W8jonas/Internet-das-Vacas/relatorios/FUTUROS testes.txt

56 des   // 10 min // 15 // 30 // 45 // 
2 sec trans
2 sec proc
