W8jonas/Internet-das-Vacas/relatorios/Relatório final/Internet das Vacas/sections/Capa_IFMG_modelo_2.tex

\begin{titlepage}
\begin{center}

% logo
~\\[1cm]

{
\newline
}

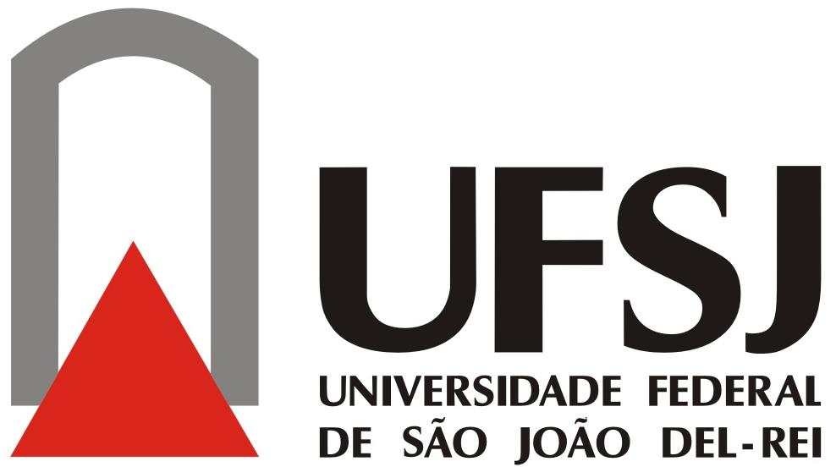
[picture p1: relatorios/Relatório final/Internet das Vacas/img/ufsj_logo.jpg]
~\\[1cm]

\textsc{\Large \\Internet das Vacas: Montagem de Placa de Protótipo de
Dispositivo IoT para Localização Inteligente do Gado}\\[3cm]

{\large \bfseries Autores: Fernando A. Teixeira \\
João Victor Carvalho Tereza \\
Jonas Henrique Nascimento \\}

\vfill

% Bottom of the page
{\large \today}
\end{center}
\end{titlepage}
