W8jonas/Internet-das-Vacas/relatorios/modelos bateria.docx

Essas duas primeiras são aquelas discutidas no último encontro, aparentemente são as melhores opções.

Bateria lipo da FullyMax – Custa 15,20 e é possível comprar nesse endereço:

http://www.asaseletricas.com.br/loja/product_info.php?products_id=4448

Bateria lipo da FullyMax – Custa 14,40 e é possível comprar nesse endereço:

http://www.asaseletricas.com.br/loja/product_info.php?products_id=4301

Em seguida temos o modelo de pilha botão da Rontek, também aparenta ser uma boa escolha, mesmo tendo baixa autonomia. Idealmente, para uma melhor autonomia seria interessante que colocássemos 2 em paralelo para dobrar a autonomia, mas para isso deveríamos adquirir 2 unidades desse modelo.

Bateria botão da Rontek - possível comprar nesses endereços:

https://produto.mercadolivre.com.br/MLB-901873283-bateria-recarregavel-bujo-36v-60mah-2-terminais-c-blister-_JM

https://produto.mercadolivre.com.br/MLB-1014502615-bateria-bujao-36v-80mah-2-terminais-_JM

https://produto.mercadolivre.com.br/MLB-706777674-bateria-bujao-36v-80mah-3-terminais-_JM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

https://produto.mercadolivre.com.br/MLB-706773838-bateria-bujao-36v-80mah-2-terminais-_JM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

Bateria lipo da Rontek –possível comprar nesses endereços:

https://produto.mercadolivre.com.br/MLB-1005574636-bateria-37v-400mah-litio-polimero-35038-_JM

https://produto.mercadolivre.com.br/MLB-1039593189-bateria-37v-450mah-litio-polimero-conector-jstp-phr-3-vias-_JM

https://produto.mercadolivre.com.br/MLB-875933973-bateria-prismatica-37v-800mah-icr063048-li-on-_JM

Bateria 18650 – Possível comprar nesses endereços:

https://pt.aliexpress.com/item/2018-1pcs-ICR-Best-selling-High-capacity-18650-rechargeable-battery-3-7V-Li-ion-Battery-for/32861972053.html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,searchweb201602_3_10152_10151_10065_10344_10068_10547_10342_10343_10340_10548_10341_10696_10084_10083_10618_10307_10846_10059_100031_524_10103_10624_10623_10622_10621_10620,searchweb201603_35,ppcSwitch_5&algo_expid=9de6b547-f8e6-4d9c-b980-1e628551992f-0&algo_pvid=9de6b547-f8e6-4d9c-b980-1e628551992f&priceBeautifyAB=0

modelo para shield:

https://produto.mercadolivre.com.br/MLB-753880552-bateria-para-radio-motorola-bp38-48v-700mah-aaa-_JM

https://produto.mercadolivre.com.br/MLB-904600437-pack-bateria-48v-700mah-bp38-radios-talkabout-intelbras-_JM
