W8jonas/Internet-das-Vacas/relatorios/Relatório final/Internet das Vacas/sections/Apendice_A.tex

\newpage
\section{Apêndice A - Tabela de valores de consumo completa}
\label{sc:apendice_a_}

{
Os valores mostrados nessa tabela foram aferidos utilizando 3 multímetros de marcas e modelos diferentes, com a principal finalidade de se chegar a uma média precisa do valor de consumo em cada situação descrita na tabela.
}

\includepdf[pages=-]{Adicionais/Tabela_valores_de_consumo_ESP.pdf}
