W8jonas/Internet-das-Vacas/relatorios/gráficos 1.xlsx

Sheet: Planilha1
valor x | valor y | valor w | em horas | em dias | valor w | em horas
3600 | 0 | 0 | 751.8796992 | 31.3283208 | 0 | 751.8796992
3599 | 0 | 1 | 649.9368117 | 27.08070049 | 1 | 649.9368117
3598 | 0 | 2 | 572.3370429 | 23.84737679 | 2 | 572.3370429
3597 | 0 | 3 | 511.2910098 | 21.30379207 | 3 | 511.2910098
3596 | 0 | 4 | 462.0123203 | 19.25051335 | 4 | 462.0123203
3595 | 0 | 5 | 421.3976355 | 17.55823481 | 5 | 421.3976355
3594 | 0 | 6 | 387.3466753 | 16.1394448 | 6 | 387.3466753
3593 | 0 | 7 | 358.3872573 | 14.93280239 | 7 | 358.3872573
3592 | 0 | 8 | 333.4568359 | 13.89403483 | 8 | 333.4568359
3591 | 0 | 9 | 311.7692907 | 12.99038711 | 9 | 311.7692907
3590 | 0 | 10 | 292.7305253 | 12.19710522 | 10 | 292.7305253
3589 | 0 | 11 | 275.8832094 | 11.49513373 | 11 | 275.8832094
3588 | 0 | 12 | 260.8695652 | 10.86956522 | 12 | 260.8695652
3587 | 0 | 13 | 247.4056766 | 10.30856986 | 13 | 247.4056766
3586 | 0 | 14 | 235.2633643 | 9.802640178 | 14 | 235.2633643
3585 | 0 | 15 | 224.2571482 | 9.344047842 | 15 | 224.2571482
3584 | 0 | 16 | 214.234706 | 8.926446084 | 16 | 214.234706
3583 | 0 | 17 | 205.0697807 | 8.544574195 | 17 | 205.0697807
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
