W8jonas/Internet-das-Vacas/relatorios/tabela 3.xlsx

Função em teste |  | VCC (V) | Mínimo (mA) | Máximo (mA) | Média (mA)
Standby(1) |  | 5 | 74,4(2) | 76.1 | 75.33333
 |  |  | 74,5(3) | 75.6
 |  |  | 75,2(4) | 76.2
 |  | 4 | 74.8 | 76 | 75.58333
 |  |  | 74.3 | 77.6
 |  |  | 74.8 | 76
 |  | 3.4 | 73.3 | 74.8 | 74.05000
 |  |  | 73.2 | 74.2
 |  |  | 73.6 | 75.2
1 Led ligado(5) |  | 5 | 75.5 | 75.2 | 75.58333
 |  |  | 75.3 | 75.3
 |  |  | 75.8 | 76.4
 |  | 4 | 75.4 | 76.8 | 76.15000
 |  |  | 75.2 | 76.5
 |  |  | 75.8 | 77.2
 |  | 3.4 | 73.8 | 74.8 | 74.36667
 |  |  | 73.3 | 74.6
 |  |  | 73.9 | 75.8
Todos os Leds ligados |  | 5 | 78.6 | 80 | 79.30000
 |  |  | 78.3 | 80.1
 |  |  | 78.8 | 80
 |  | 4 | 78.6 | 79.5 | 79.06667
 |  |  | 78.2 | 79.3
 |  |  | 78.8 | 80
 |  | 3.4 | 76.2 | 78.1 | 77.13333
 |  |  | 75.9 | 77.2
 |  |  | 76.5 | 78.9
100% uso do CPU(6) |  | 5 | 76 | 77.3 | 76.90000
 |  |  | 76 | 76.3
 |  |  | 76.6 | 79.2
 |  | 4 | 75.5 | 76.6 | 76.23333
 |  |  | 75.3 | 76.6
 |  |  | 75.9 | 77.5
 |  | 3.4 | 74.8 | 75.5 | 75.16667
 |  |  | 74.4 | 75.2
 |  |  | 74.9 | 76.2
1 Led ligado + 100% uso CPU |  | 5 | 76.8 | 78.1 | 77.78333
 |  |  | 76.4 | 77.7
 |  |  | 78.2 | 79.5
 |  | 4 | 76.8 | 77.6 | 77.38333
 |  |  | 76.7 | 77.3
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
