W8jonas/Internet-das-Vacas/relatorios/filtro para tabela modelos de bateria minamoto.xlsx

Tabela retirada DIRETAMENTE do site minamoto. Pode ser acessado inteiramente no link: http://www.minamoto.com/12591-2/
Data de acesso: 05/06/2018
Model | Nominal Capacity (mAh) | Nominal Voltage (V) | Thickness (mm) | Width (mm) | Height (mm) | Weight (g) | Max. Continuous Current | Max. Pulse Current
Model | Nominal Capacity (mAh) | Nominal Voltage (V) | Thickness (mm) | Width (mm) | Height (mm) | Weight (g) | Max. Continuous Current | Max. Pulse Current
LP8574135 | 10Ah | 3.7 | 8.7 | 73.5 | 135 | 136 | 1C | 2C
LP7543128 | 5000 | 3.7 | 7.7 | 43 | 128 | 94 | 1C | 2C
LP8045135P | 5000 | 3.7 | 8 | 45 | 135 | 106 | 1C | 2C
LP6848135 | 5000 | 3.7 | 6.5 | 48 | 135 | 88 | 1C | 2C
LP104884 | 5000 | 3.7 | 10 | 48 | 84 | 86 | 1C | 2C
LP806580 | 5000 | 3.7 | 8.5 | 65 | 80 | 92 | 1C | 2C
LP805095 | 4500 | 3.7 | 7.8 | 50 | 95 | 81 | 1C | 2C
LP5548135 | 4200 | 3.7 | 5.6 | 48 | 135 | 79 | 1C | 2C
LP5567102 | 4100 | 3.7 | 4.8 | 66 | 102 | 73 | 1C | 2C
LP6443128 | 4000 | 3.7 | 6 | 43 | 128 | 73 | 1C | 2C
LP824884 | 4000 | 3.7 | 8.5 | 48 | 84 | 73 | 1C | 2C
LP705585 | 4000 | 3.7 | 7.2 | 55 | 85 | 72 | 1C | 2C
LP804884 | 3900 | 3.7 | 7.8 | 48 | 84 | 68 | 1C | 2C
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
