W8jonas/Internet-das-Vacas/relatorios/Internet das vacas PIBIC-Jonas.xlsx

Data | Dia da semana | Atividade realizada
2018-02-27 | Terça-feira | Confirmação da Fapemig
2018-02-28 | Quarta-feira | Coleta das assinaturas
2018-03-03 | Sábado | Cadastramento EVEREST
2018-03-21 | Quarta-feira | Confirmação da proposta no EVEREST
