W8jonas/Internet-das-Vacas/imagens/Circuito leitor de tensao/01.jpeg

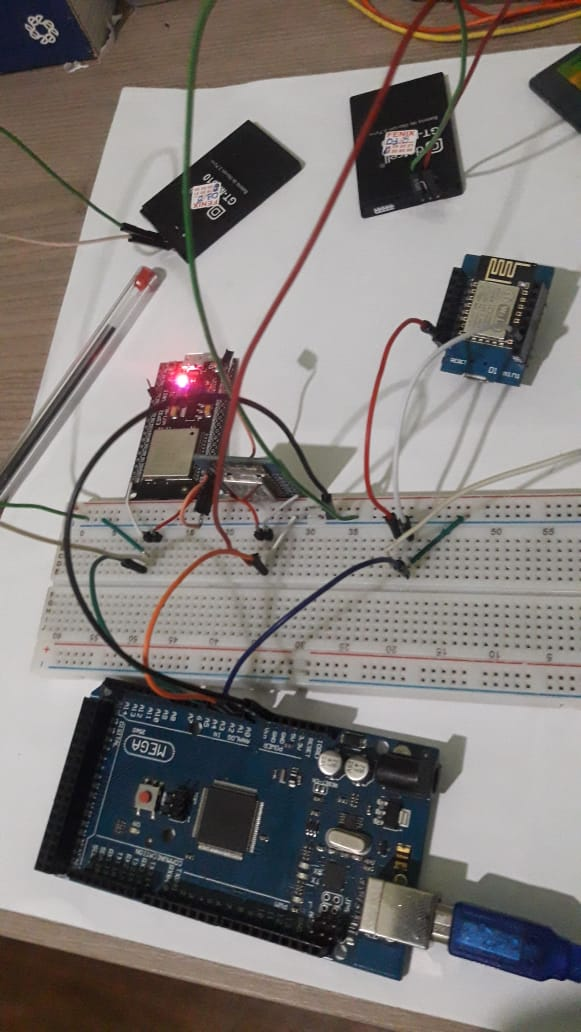
imagens/Circuito leitor de tensao/01.jpeg
