W8jonas/Internet-das-Vacas/imagens/Circuito leitor de tensao/02.jpeg

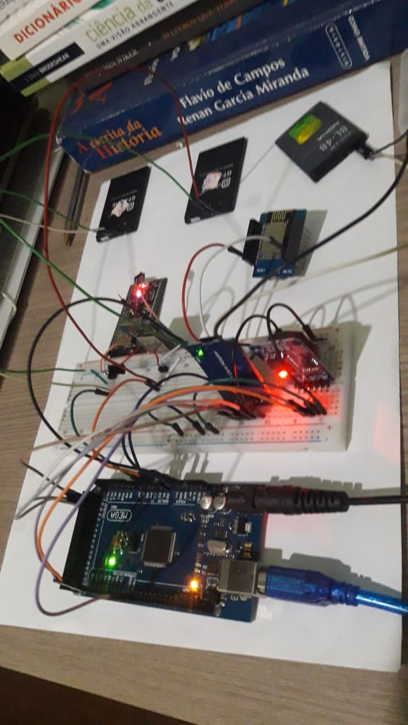
imagens/Circuito leitor de tensao/02.jpeg
