W8jonas/Internet-das-Vacas/imagens/Circuito leitor de tensao/03.jpeg

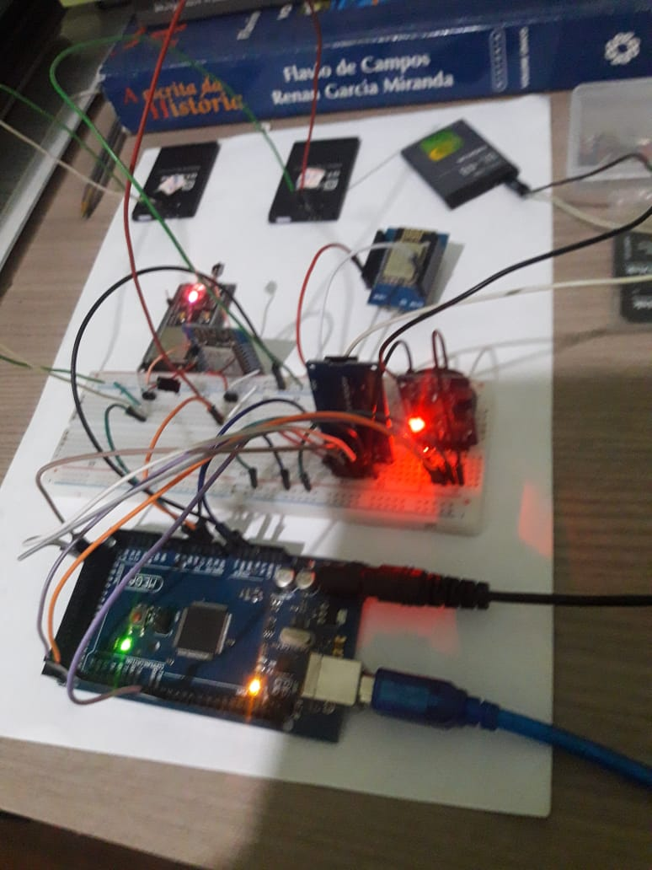
imagens/Circuito leitor de tensao/03.jpeg
