W8jonas/Internet-das-Vacas/imagens/Circuito leitor de tensao/06.jpeg

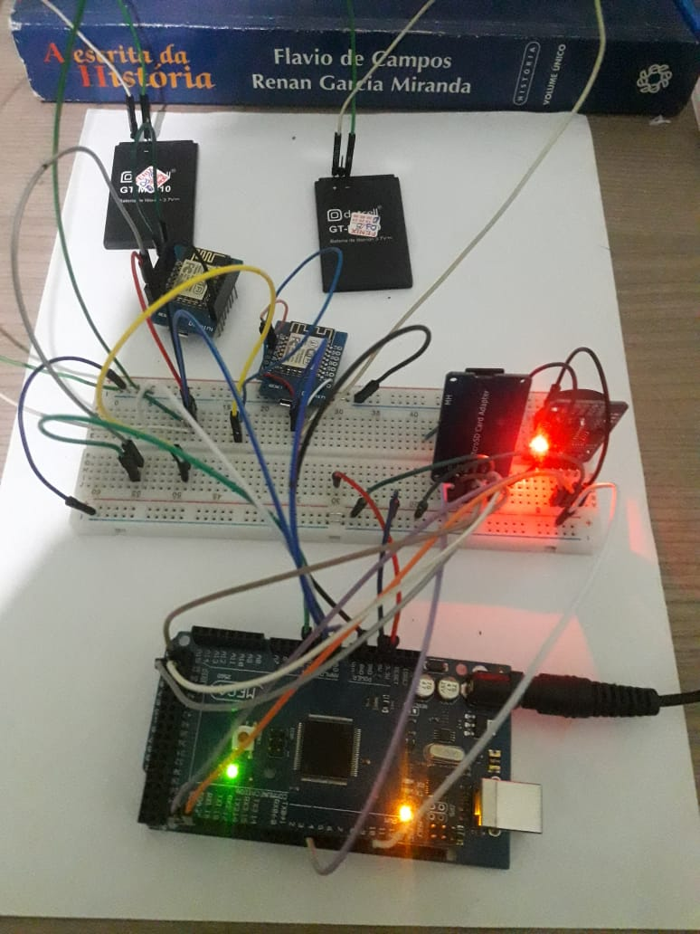
imagens/Circuito leitor de tensao/06.jpeg
