W8jonas/Internet-das-Vacas/imagens/Circuito leitor de tensao/07.jpeg

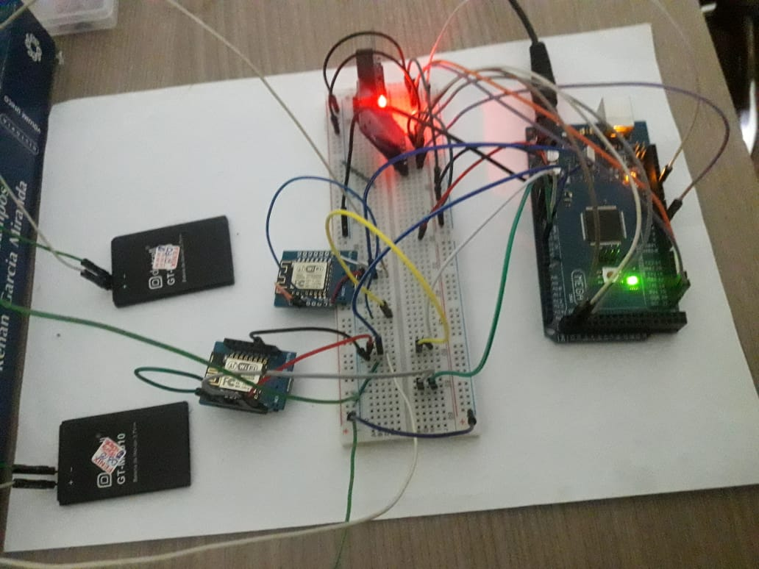
imagens/Circuito leitor de tensao/07.jpeg
