W8jonas/Internet-das-Vacas/imagens/Circuito leitor de tensao/08.jpeg

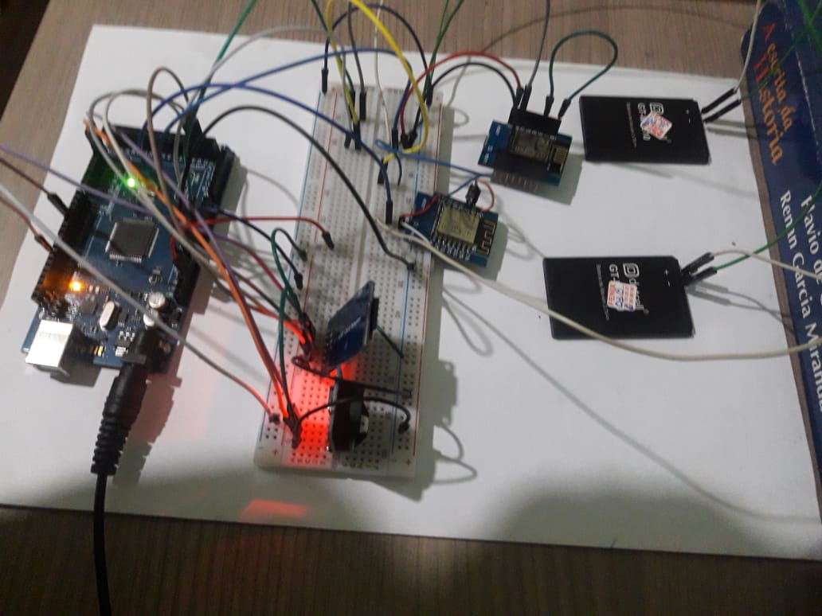
imagens/Circuito leitor de tensao/08.jpeg
