W8jonas/Internet-das-Vacas/imagens/Circuito leitor de tensao/09.jpeg

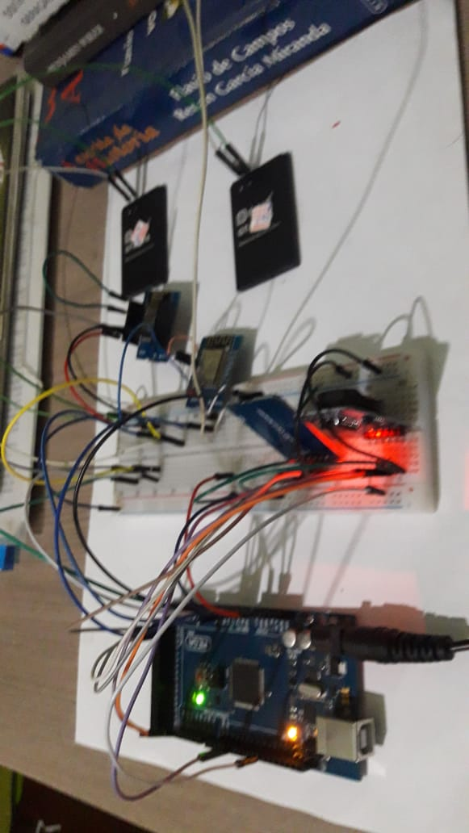
imagens/Circuito leitor de tensao/09.jpeg
