W8jonas/Internet-das-Vacas/imagens/Circuito leitor de tensao/10.jpeg

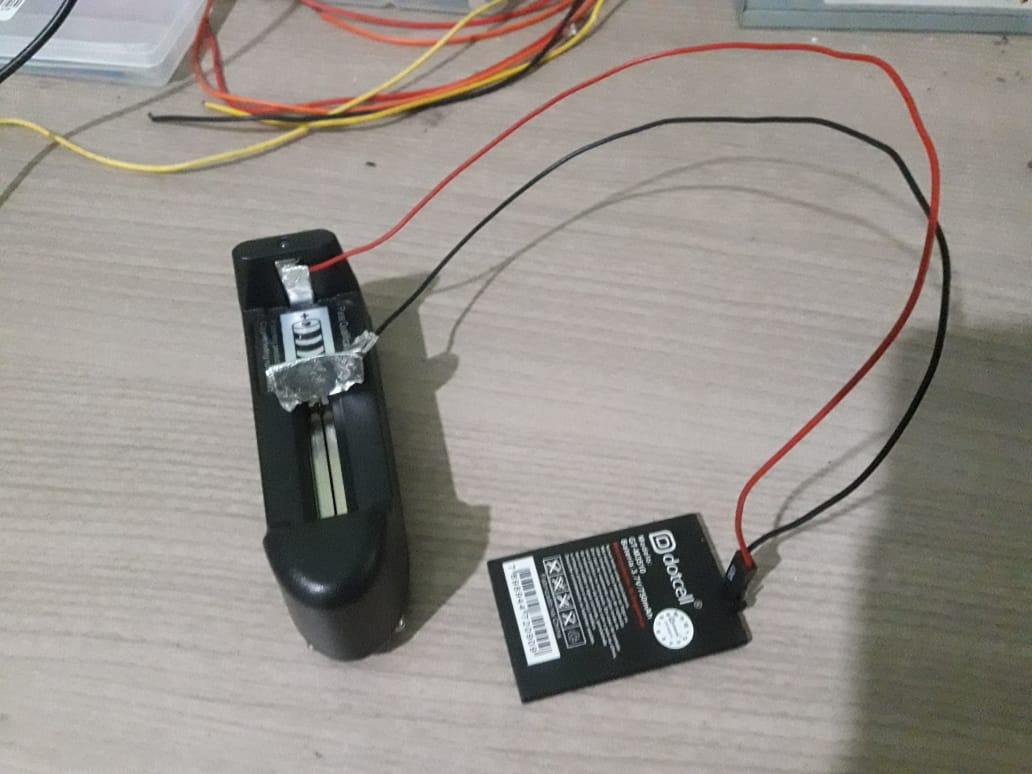
imagens/Circuito leitor de tensao/10.jpeg
