W8jonas/Internet-das-Vacas/imagens/Protótipo 1 ESP32/01.jpeg

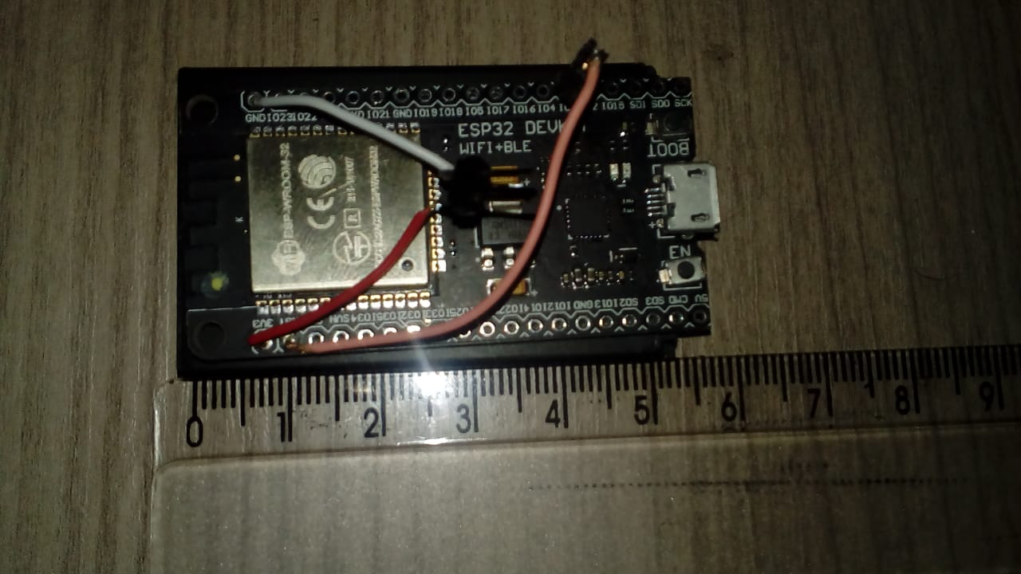
imagens/Protótipo 1 ESP32/01.jpeg
