W8jonas/Internet-das-Vacas/imagens/Protótipo 1 ESP32/03.jpeg

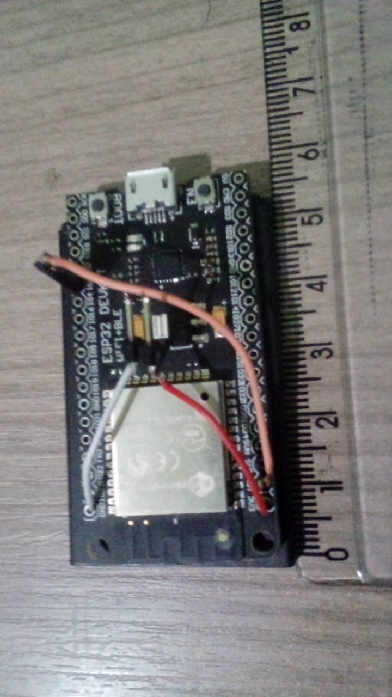
imagens/Protótipo 1 ESP32/03.jpeg
