W8jonas/Internet-das-Vacas/imagens/Protótipo 1 ESP32/10.jpeg

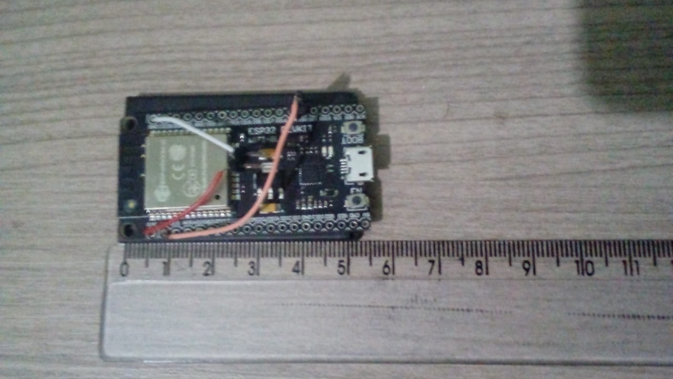
imagens/Protótipo 1 ESP32/10.jpeg
