W8jonas/Internet-das-Vacas/imagens/Protótipo 1 ESP8266/02.jpeg

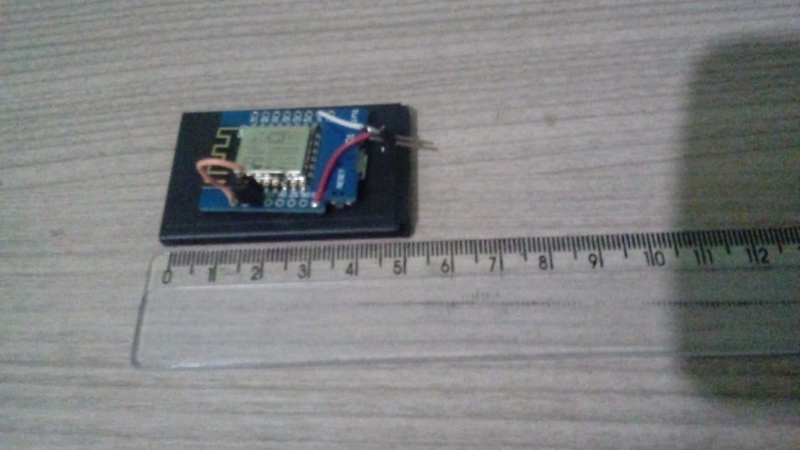
imagens/Protótipo 1 ESP8266/02.jpeg
