W8jonas/Internet-das-Vacas/imagens/Protótipo 1 ESP8266/07.jpeg

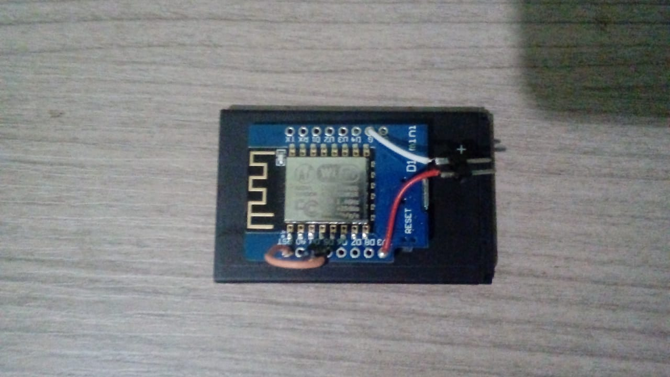
imagens/Protótipo 1 ESP8266/07.jpeg
