W8jonas/Internet-das-Vacas/imagens/Protótipo 1 ESP8266/11.jpeg

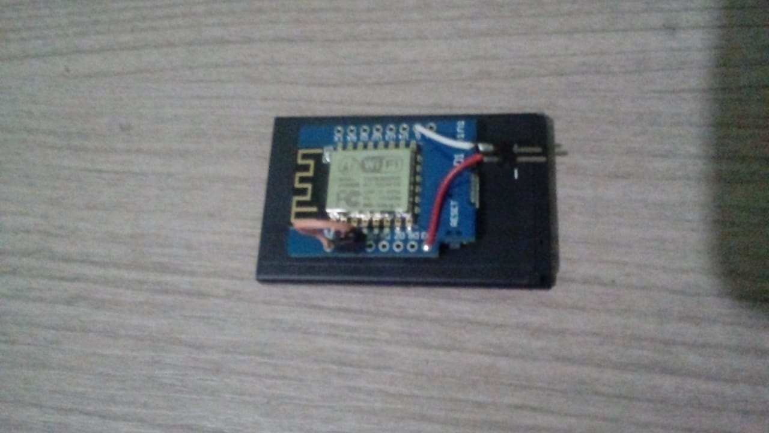
imagens/Protótipo 1 ESP8266/11.jpeg
