W8jonas/Internet-das-Vacas/imagens/Protótipo 1/01.jpeg

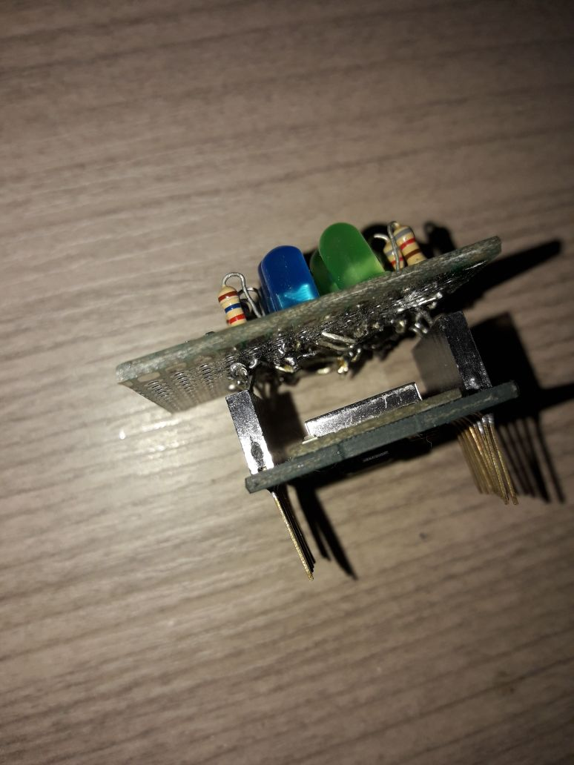
imagens/Protótipo 1/01.jpeg
