W8jonas/Internet-das-Vacas/imagens/Protótipo 1/02.jpeg

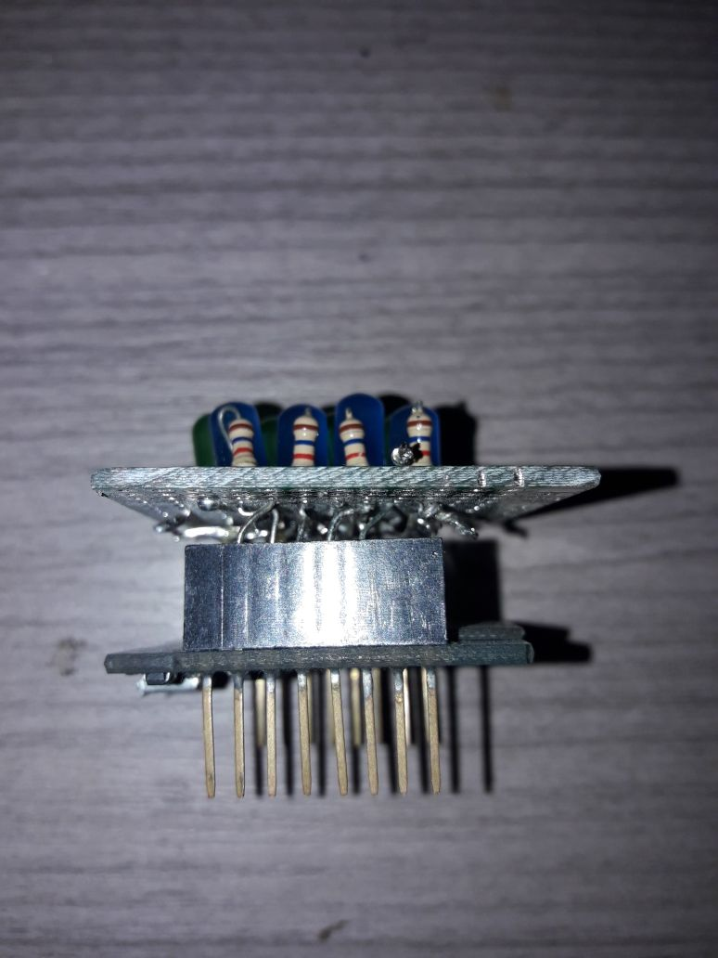
imagens/Protótipo 1/02.jpeg
