W8jonas/Internet-das-Vacas/imagens/Protótipo 1/04.jpeg

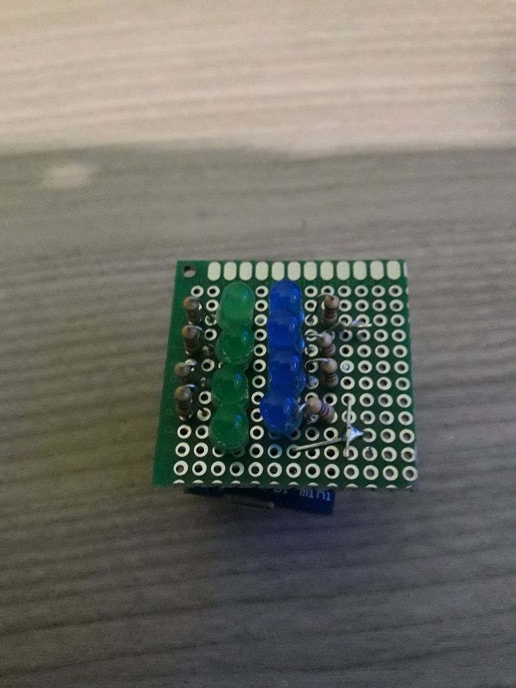
imagens/Protótipo 1/04.jpeg
