W8jonas/Internet-das-Vacas/imagens/Protótipo 1/05.jpeg

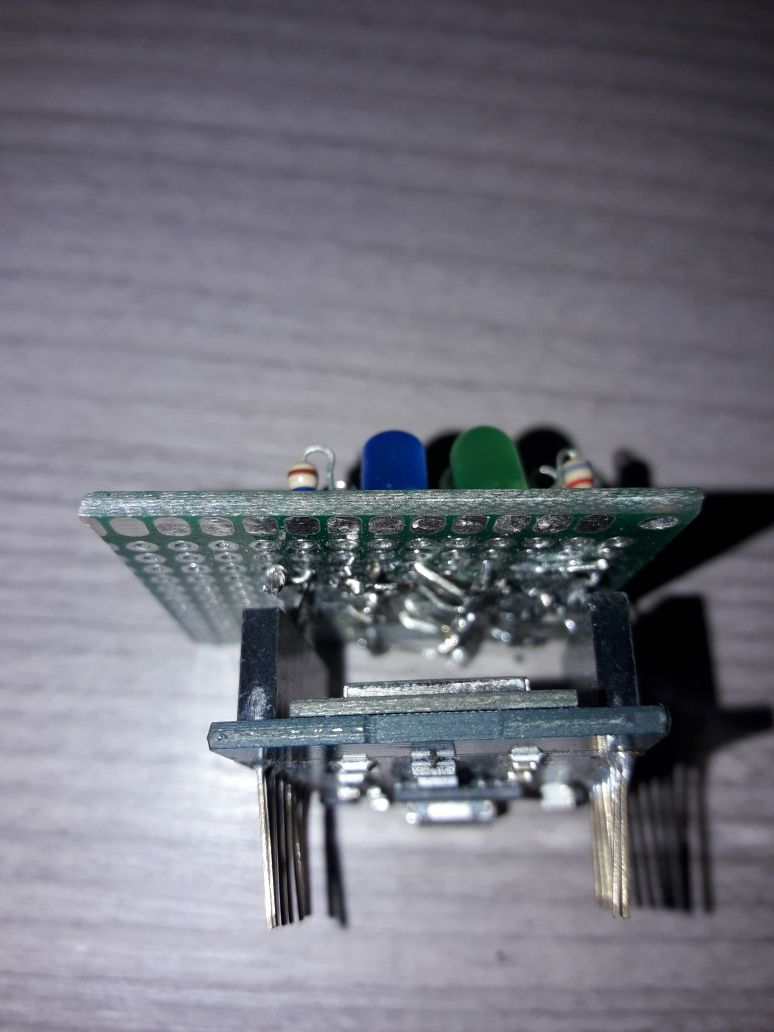
imagens/Protótipo 1/05.jpeg
