W8jonas/Internet-das-Vacas/imagens/Protótipo 1/06.jpeg

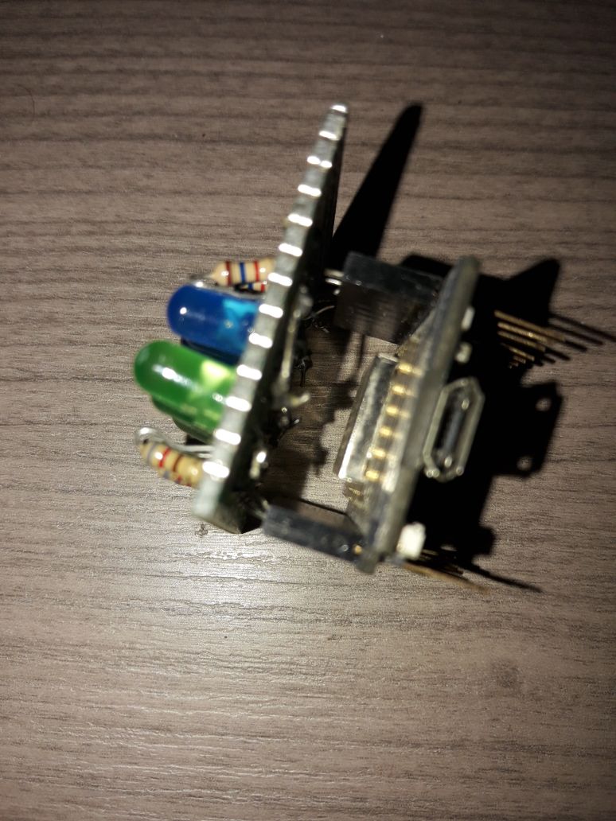
imagens/Protótipo 1/06.jpeg
