W8jonas/Internet-das-Vacas/imagens/Protótipo 1/07.jpeg

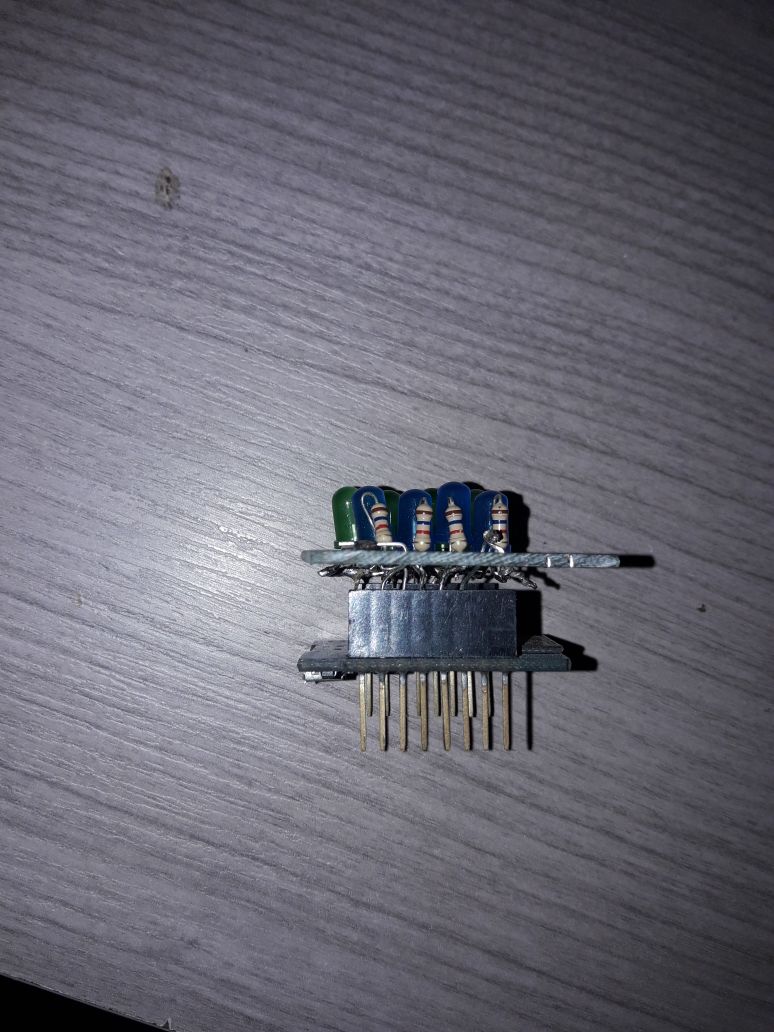
imagens/Protótipo 1/07.jpeg
