W8jonas/Internet-das-Vacas/imagens/Protótipo 1/08.jpeg

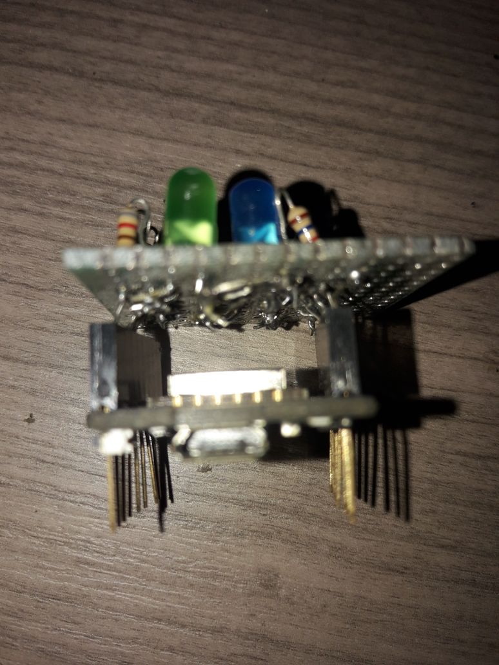
imagens/Protótipo 1/08.jpeg
