W8jonas/Internet-das-Vacas/imagens/Protótipo 1/10.jpeg

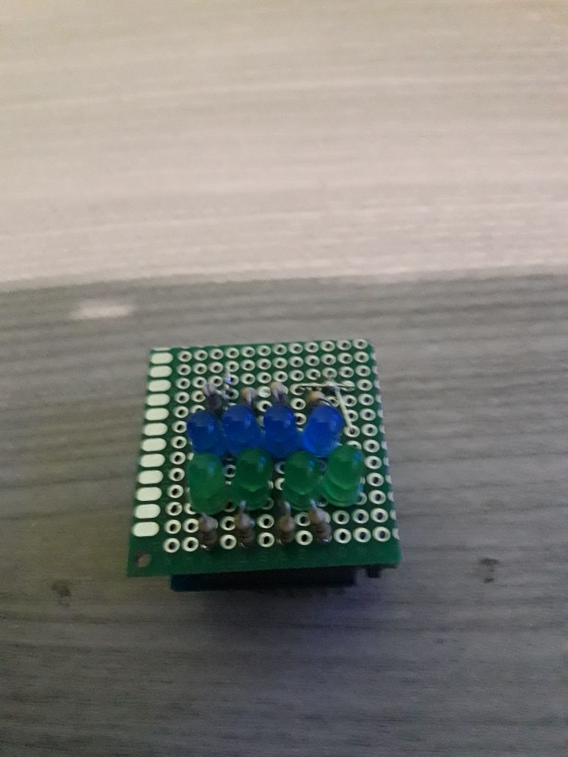
imagens/Protótipo 1/10.jpeg
