W8jonas/Internet-das-Vacas/imagens/Protótipo 1/11.jpeg

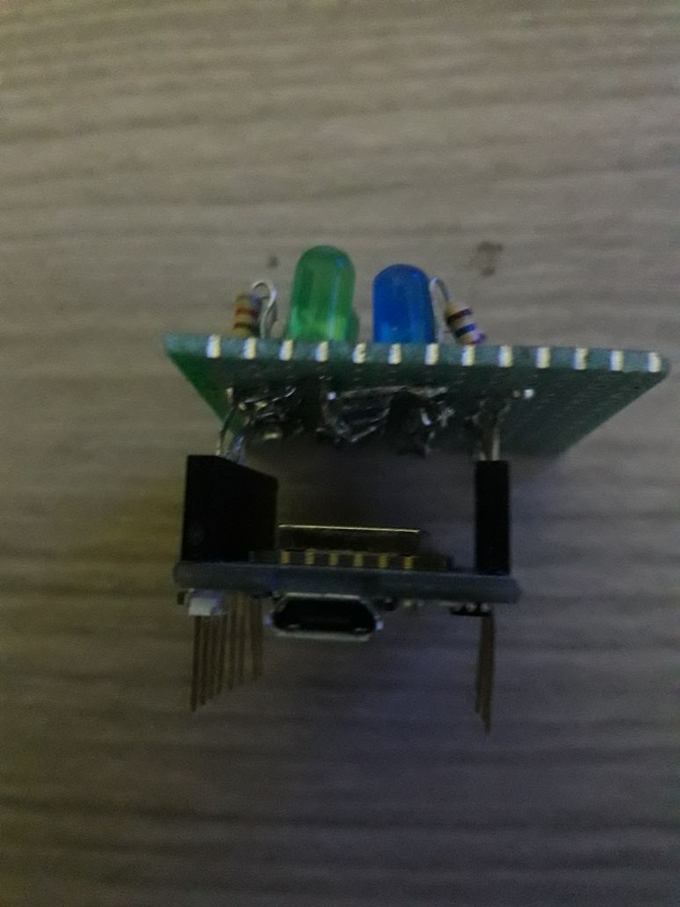
imagens/Protótipo 1/11.jpeg
