W8jonas/Internet-das-Vacas/imagens/Protótipo 1/13.jpeg

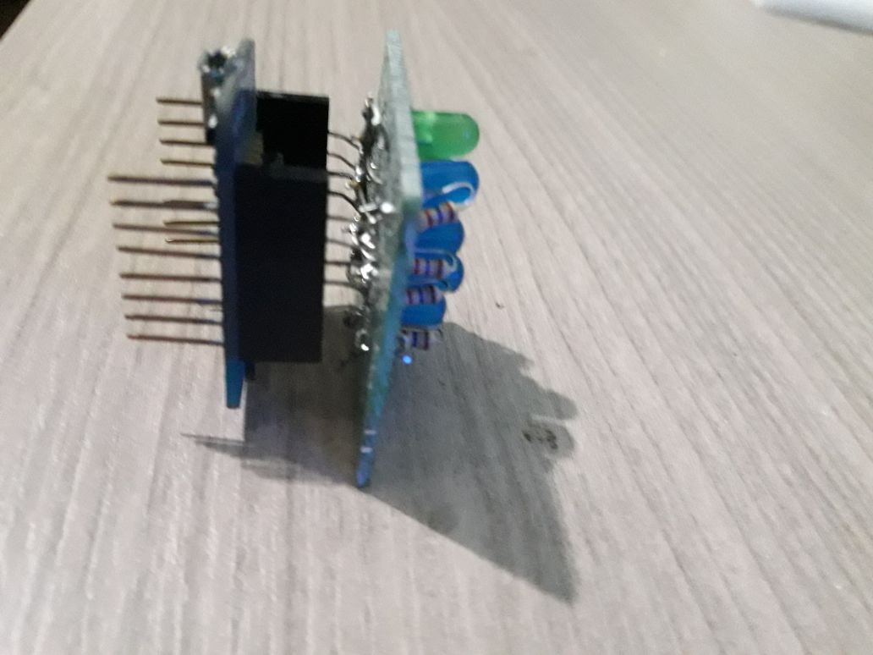
imagens/Protótipo 1/13.jpeg
