W8jonas/Internet-das-Vacas/imagens/Protótipo 1/14.jpeg

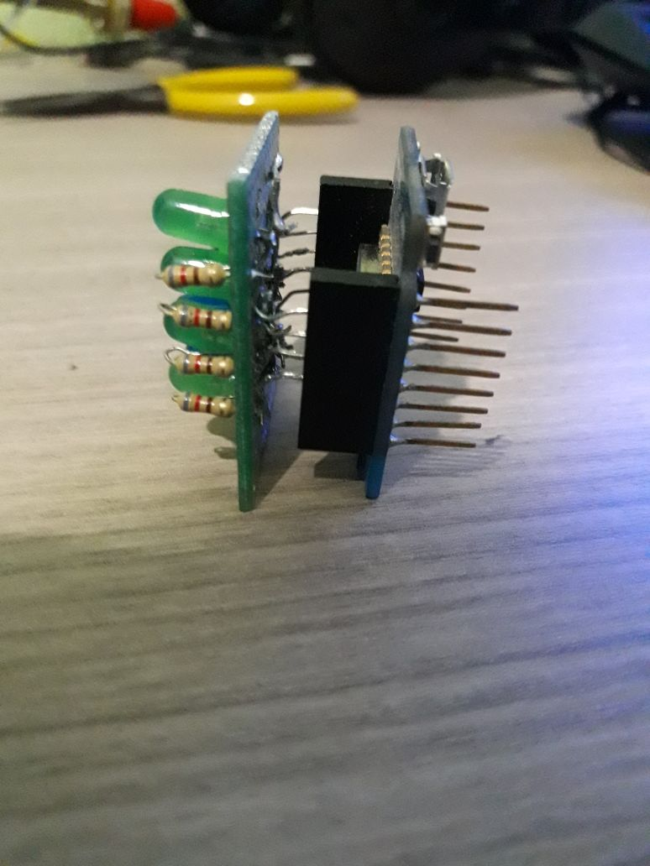
imagens/Protótipo 1/14.jpeg
