W8jonas/Internet-das-Vacas/imagens/Protótipo 1/15.jpeg

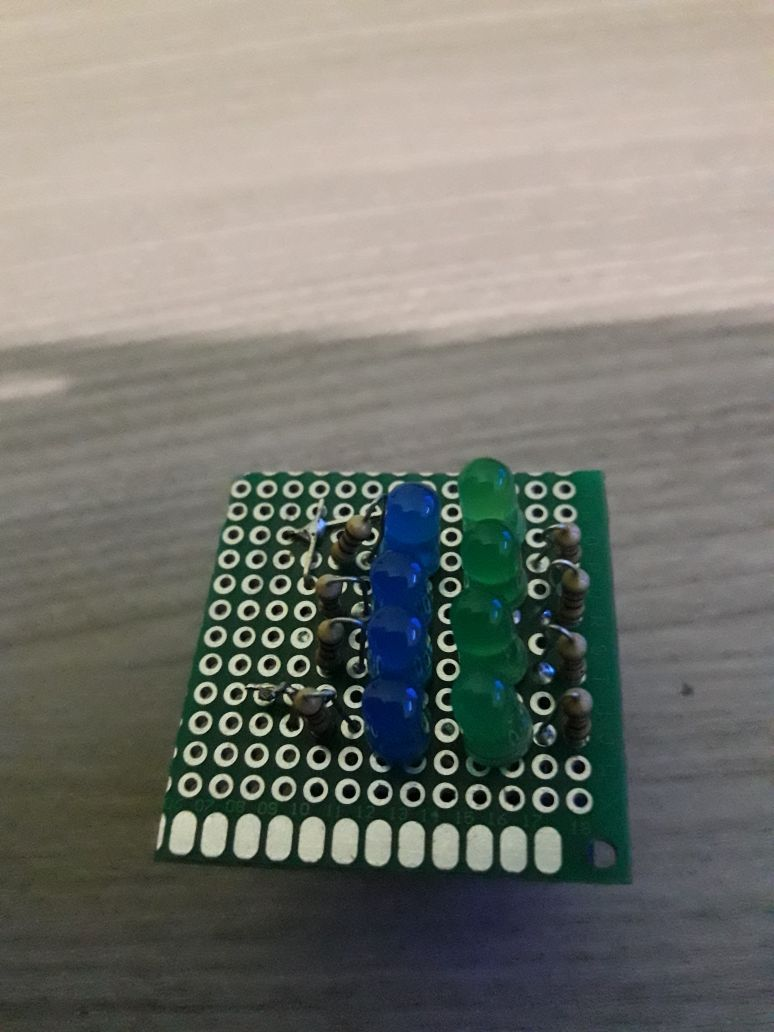
imagens/Protótipo 1/15.jpeg
