W8jonas/Internet-das-Vacas/imagens/Protótipo 1/16.jpeg

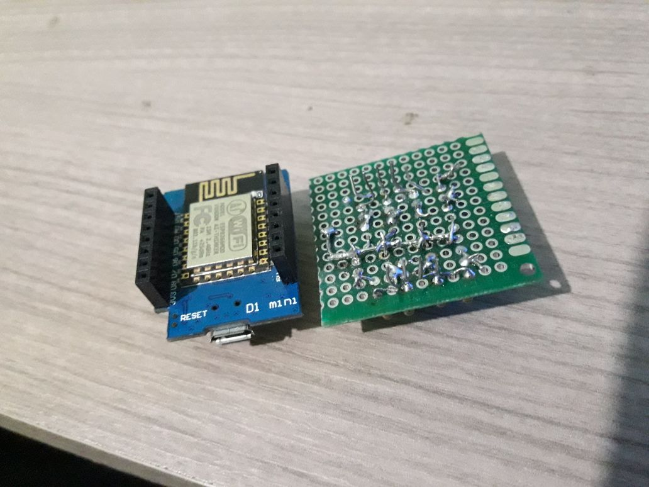
imagens/Protótipo 1/16.jpeg
