W8jonas/Internet-das-Vacas/imagens/Protótipo 2/02.jpeg

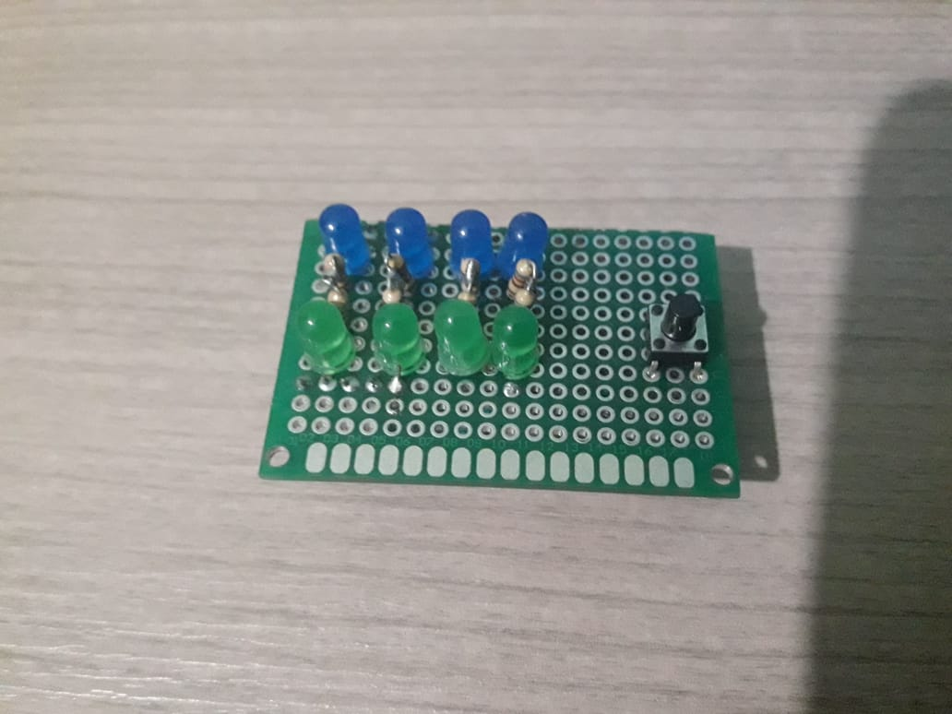
imagens/Protótipo 2/02.jpeg
