W8jonas/Internet-das-Vacas/imagens/Protótipo 2/04.jpeg

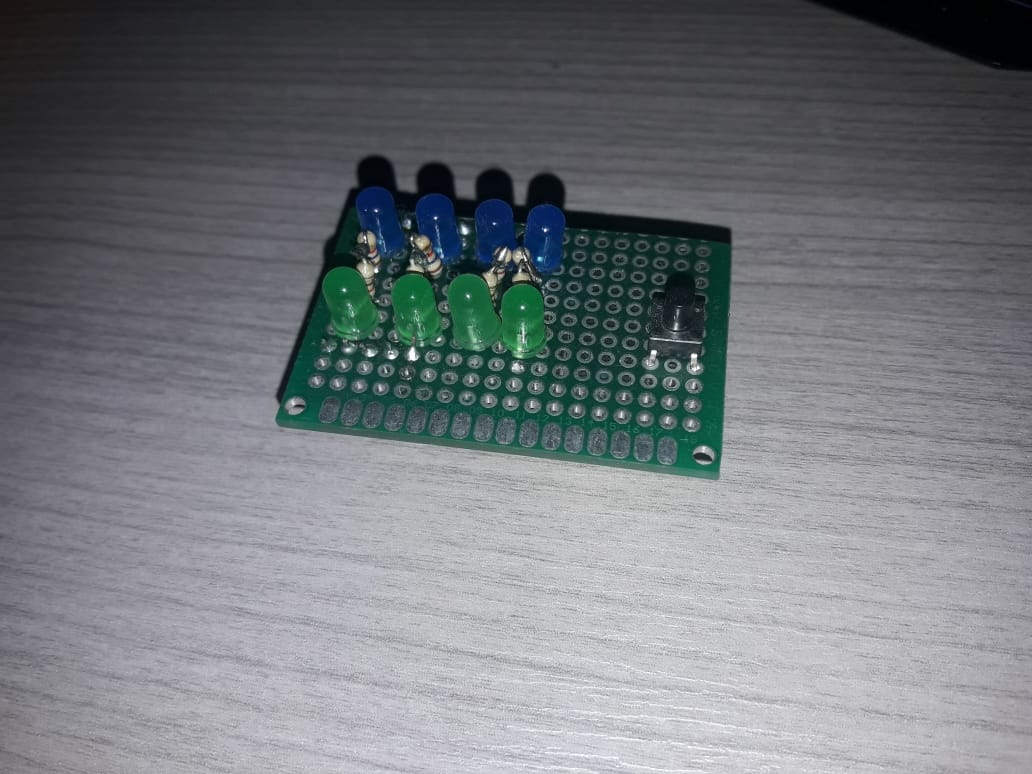
imagens/Protótipo 2/04.jpeg
