W8jonas/Internet-das-Vacas/imagens/Protótipo 2/05.jpeg

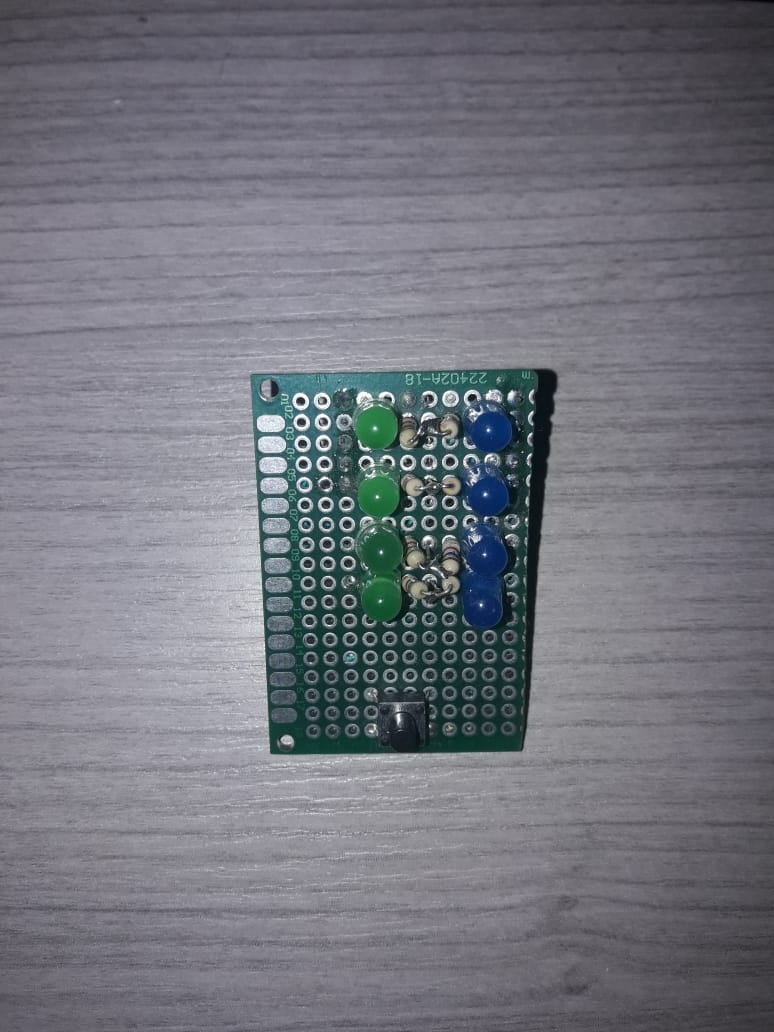
imagens/Protótipo 2/05.jpeg
