W8jonas/Internet-das-Vacas/imagens/Protótipo 2/06.jpeg

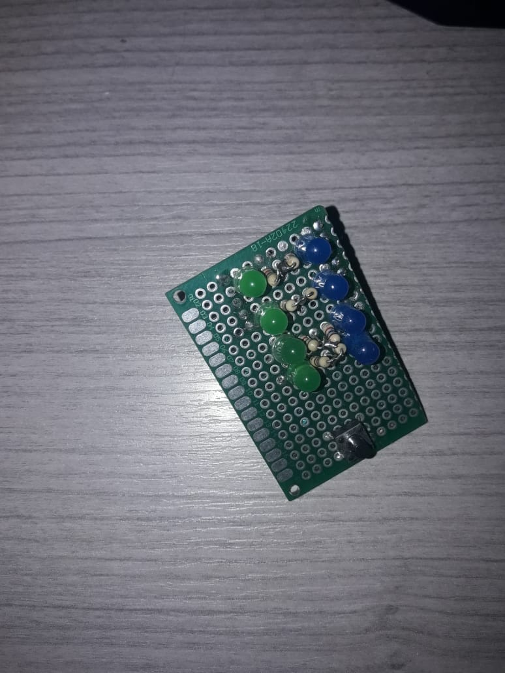
imagens/Protótipo 2/06.jpeg
