W8jonas/Internet-das-Vacas/imagens/Protótipo 2/07.jpeg

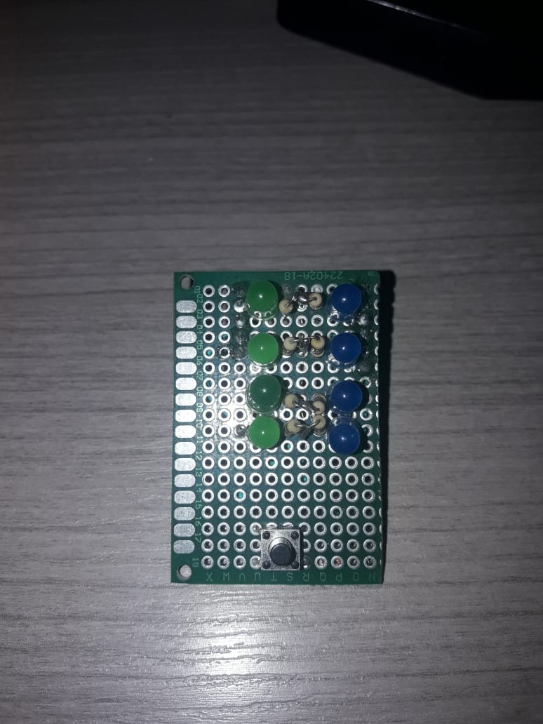
imagens/Protótipo 2/07.jpeg
