W8jonas/Internet-das-Vacas/imagens/Protótipo 2/08.jpeg

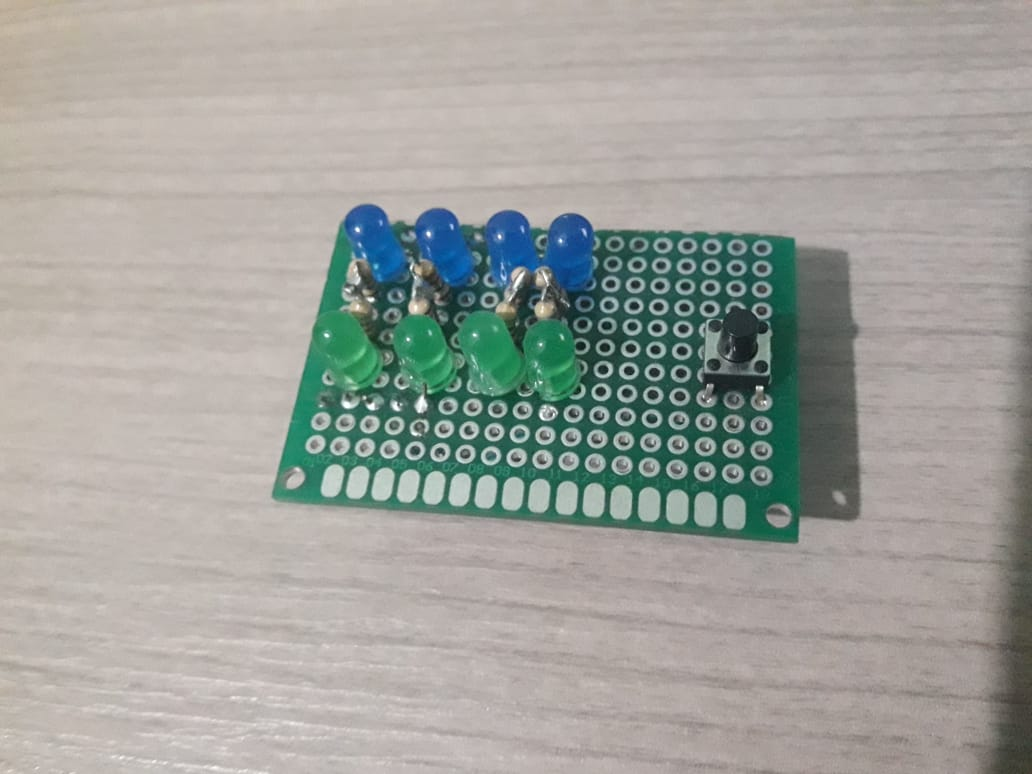
imagens/Protótipo 2/08.jpeg
