W8jonas/Internet-das-Vacas/imagens/Protótipo 2/09.jpeg

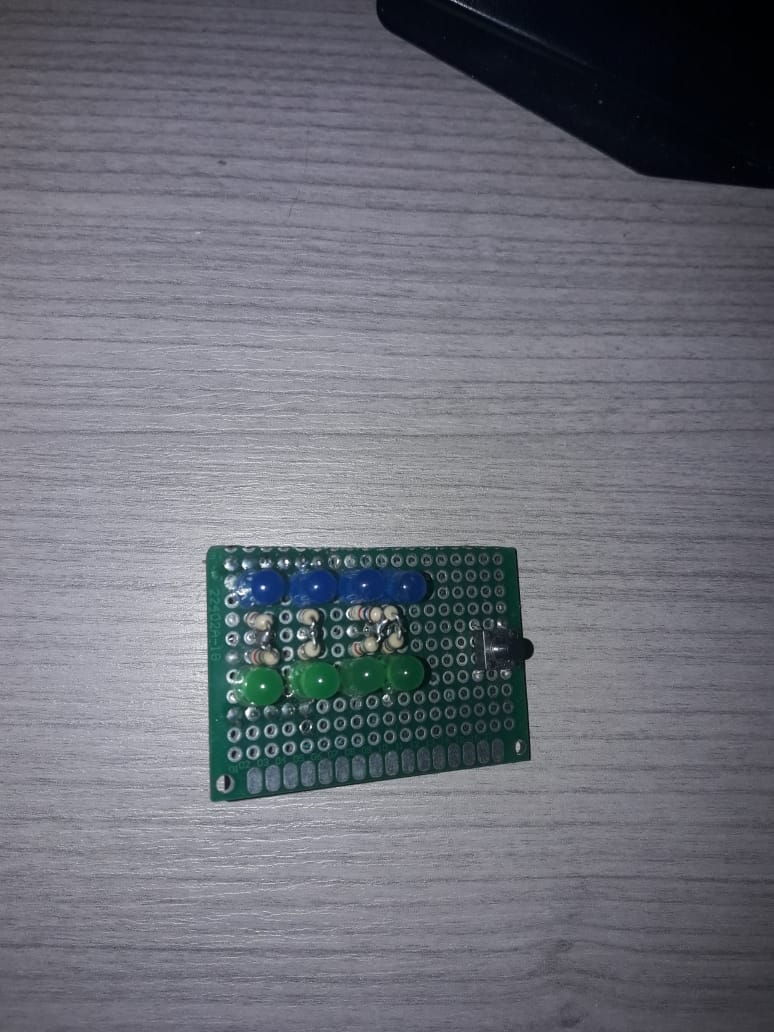
imagens/Protótipo 2/09.jpeg
