W8jonas/Internet-das-Vacas/imagens/Protótipo 2/10.jpeg

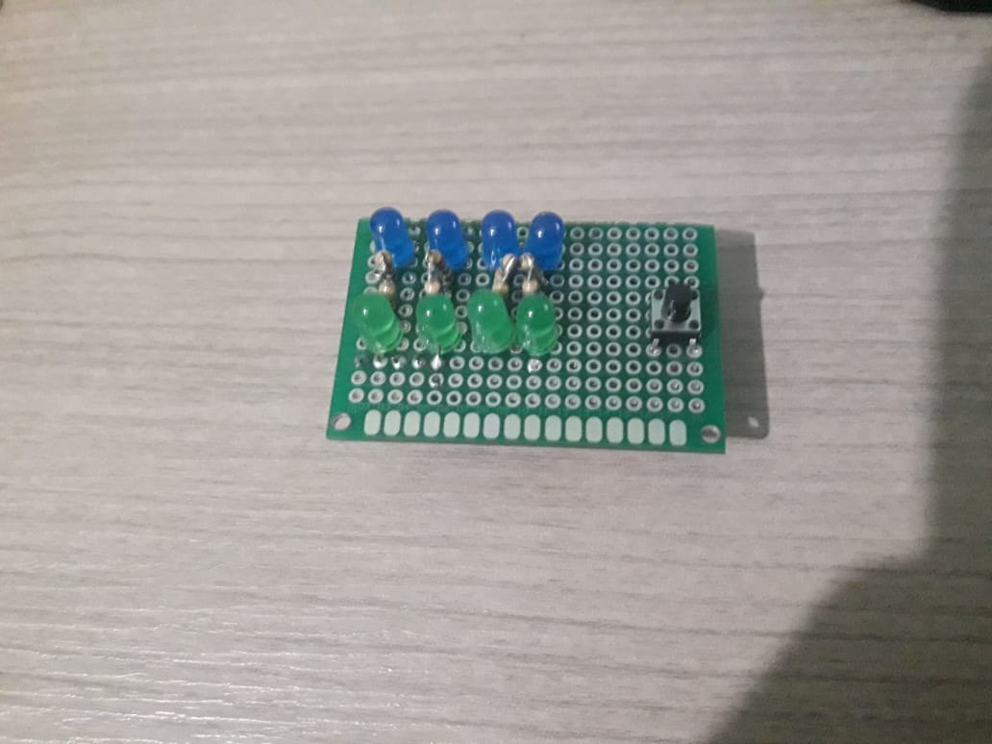
imagens/Protótipo 2/10.jpeg
