W8jonas/Internet-das-Vacas/imagens/Protótipo 2/11.jpeg

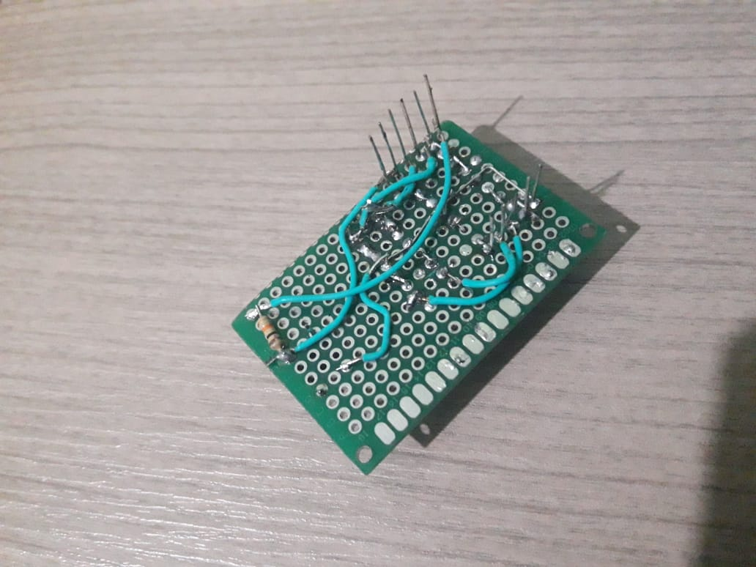
imagens/Protótipo 2/11.jpeg
