W8jonas/Internet-das-Vacas/imagens/Protótipo 2/12.jpeg

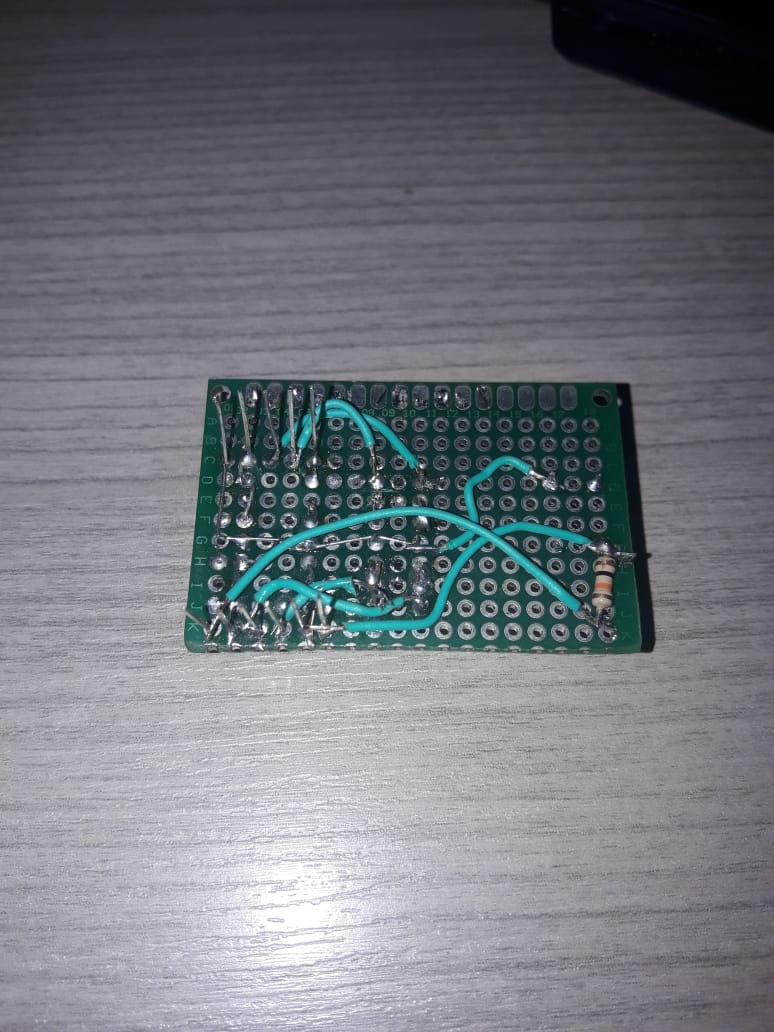
imagens/Protótipo 2/12.jpeg
