W8jonas/Internet-das-Vacas/imagens/Protótipo 2/13.jpeg

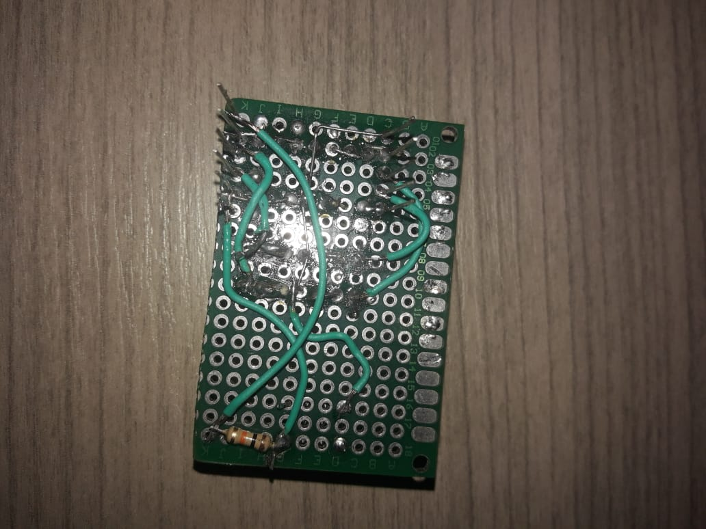
imagens/Protótipo 2/13.jpeg
