W8jonas/Internet-das-Vacas/imagens/Protótipo 2/14.jpeg

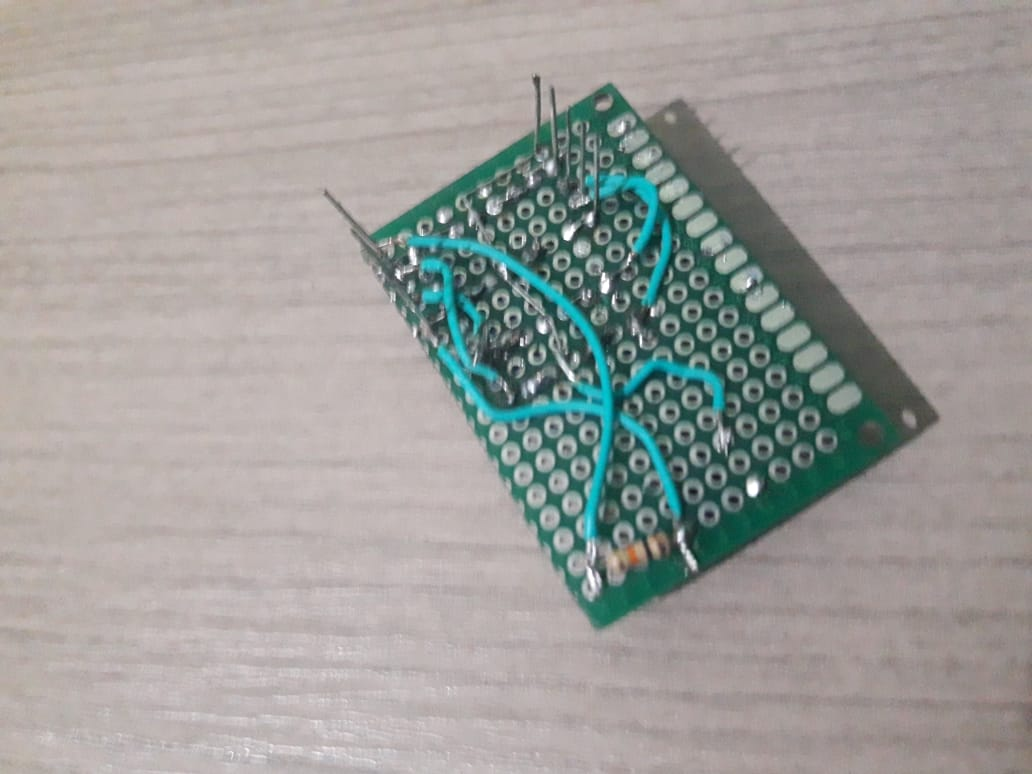
imagens/Protótipo 2/14.jpeg
