W8jonas/Internet-das-Vacas/imagens/protótipo ESP8266.jpeg

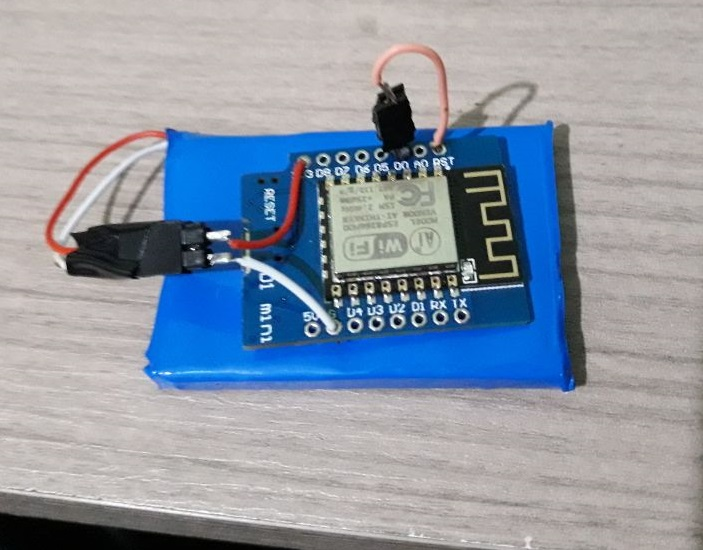
imagens/protótipo ESP8266.jpeg
