W8jonas/Internet-das-Vacas/imagens/RSSI e NOT-RSSI.png

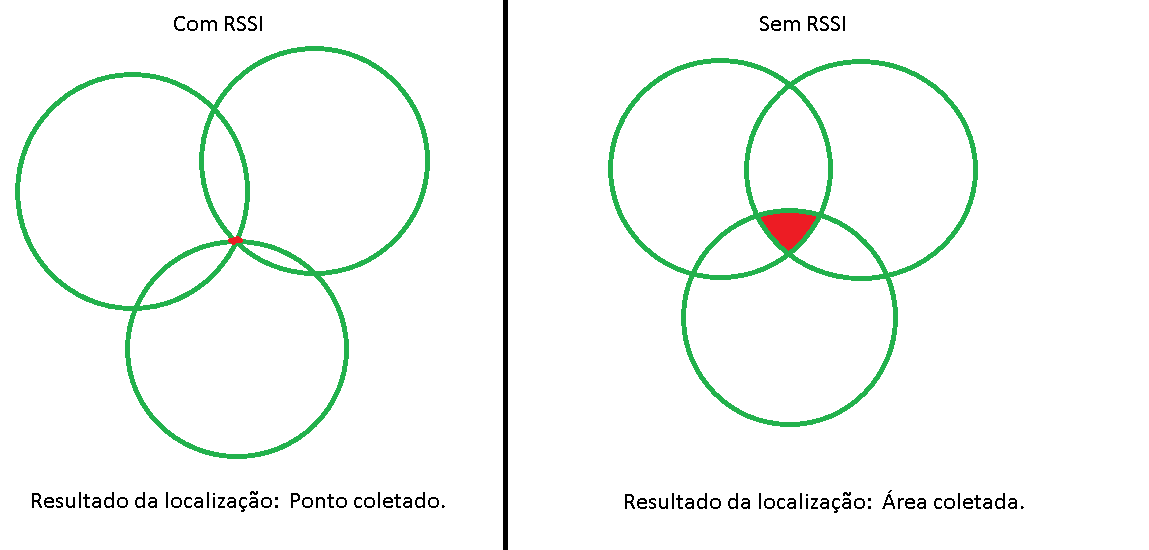
imagens/RSSI e NOT-RSSI.png
