W8jonas/Internet-das-Vacas/relatorios/compras masterwalker.png

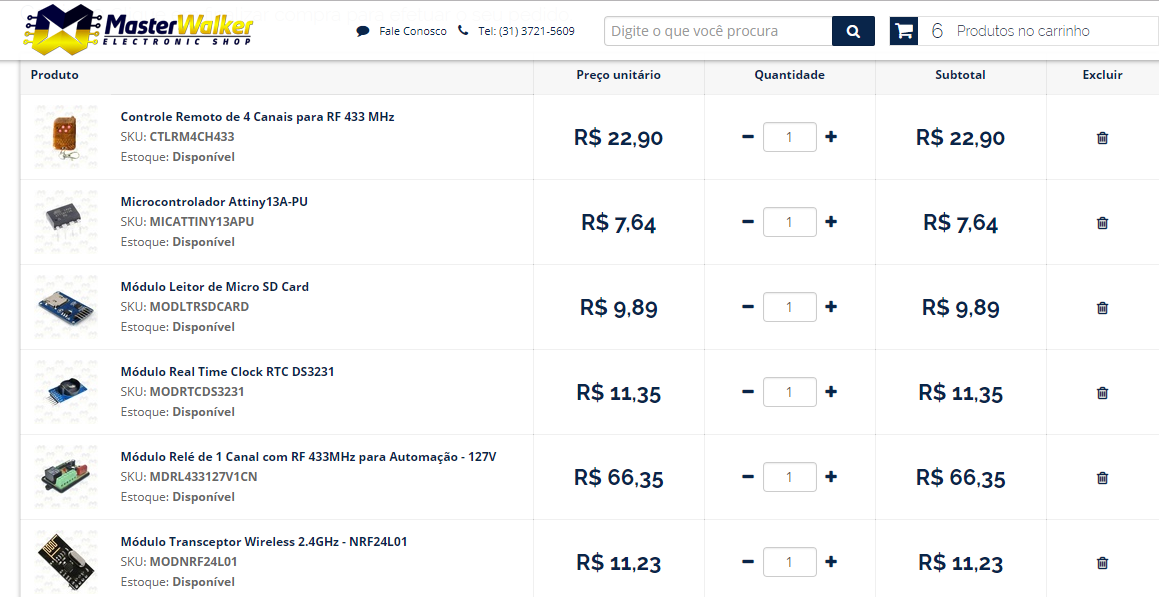
relatorios/compras masterwalker.png
