W8jonas/Internet-das-Vacas/relatorios/Compras.png

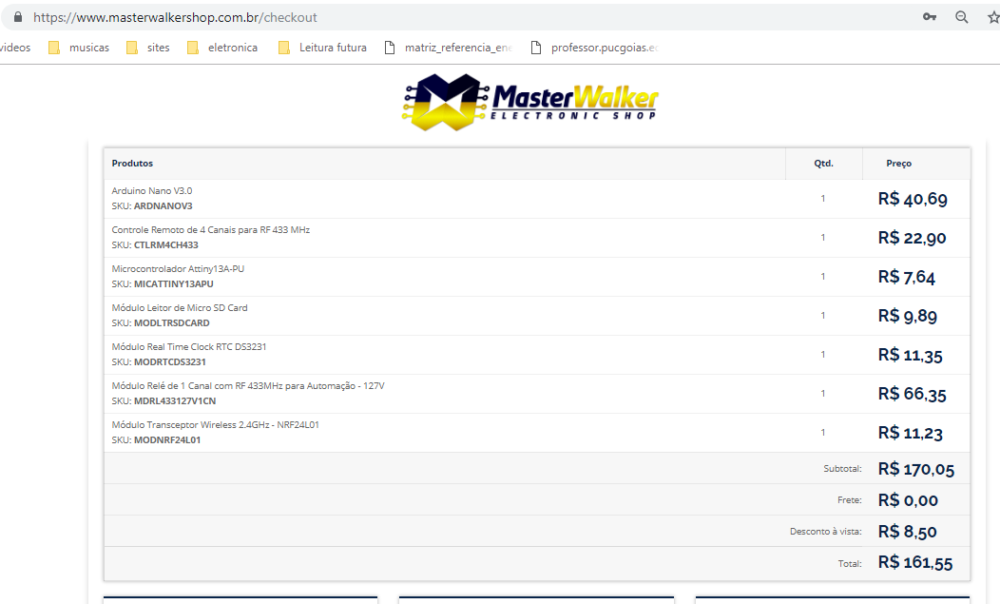
relatorios/Compras.png
