W8jonas/Internet-das-Vacas/relatorios/Relatório final/Internet das Vacas/img/medidor_de_tesao_01.jpeg

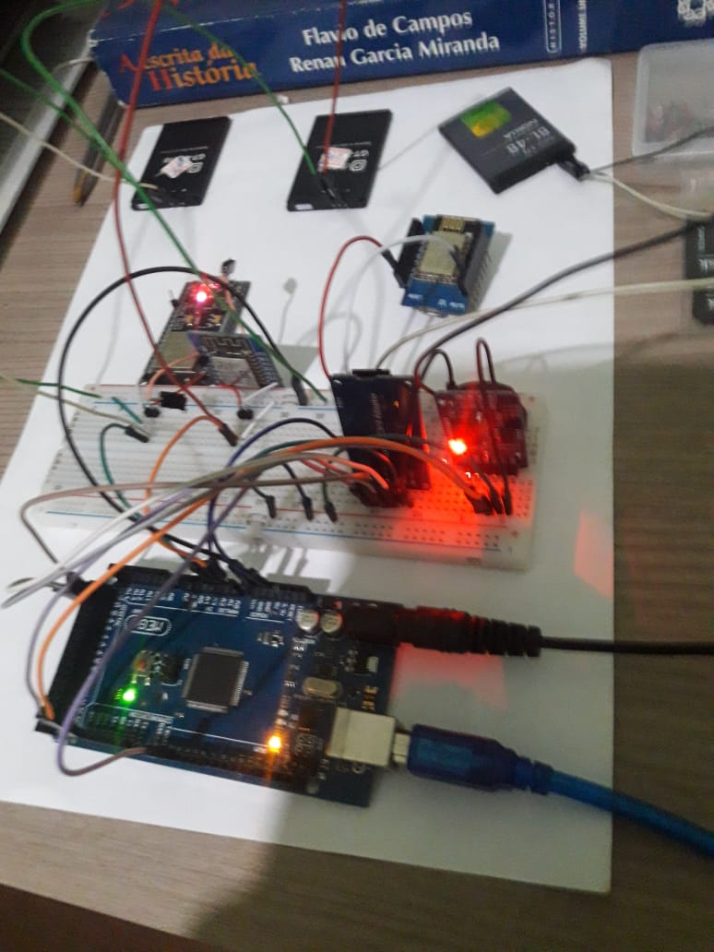
relatorios/Relatório final/Internet das Vacas/img/medidor_de_tesao_01.jpeg
