W8jonas/Internet-das-Vacas/relatorios/tabela 2.xlsx

Numeração | Marca | Modelo | Modelo químico | Dimensões(mm) |  |  | Modelo de tamanho | Preço | Tensão de trabalho | mAh | Wh | Custo/wh
 |  |  |  | C | L | A
1 | Rontek | RT300AAAB4 |  | 11 | 44 | 11 |  | R$3.50 | 1.20 | 300.00 | 360.00 | 0.009722
2 | Energy Power | AA NI-Mh |  | 14.5 | 50.5 | 14.5 |  | R$8.90 | 1.20 | 800.00 | 960.00 | 0.009271
3 | Energy Power | AA NI-Cd |  | 14.5 | 50.5 | 14.5 |  | R$9.50 | 1.20 | 1000.00 | 1200.00 | 0.007917
4 | Rontek | AA NI-Mh |  | 14.5 | 50.5 | 14.5 |  | R$7.50 | 1.20 | 2100.00 | 2520.00 | 0.002976
5 | Mox | Aaa |  | 14.5 | 50.5 | 14.5 |  | R$3.80 | 1.20 | 3600.00 | 4320.00 | 0.000880
6 | Knup | KP-BT9V |  | 47 | 20 | 15 |  | R$12.00 | 9.00 | 450.00 | 4050.00 | 0.002963
7 | FLEX | FX-9V/450 |  | 47 | 20 | 15 |  | R$35.00 | 9.00 | 450.00 | 4050.00 | 0.008642
8 |  | Bateria de LIPO |  | 30 | 50 | 6 |  | R$15.00 | 3.70 | 900.00 | 3330.00 | 0.004505
9 | Bailong | - |  | - | - | - |  | R$9.90 | 4.20 | 6800.00 | 28560.00 | 0.000347
10 | Rontek | Talkabout |  |  |  |  |  | R$19.00 | 3.70 | 650.00 | 2405.00 | 0.007900
11 | Rontek | 6RT1800SC-CX |  | 131 | 51 | 23 |  | orçamento | 7.20 | 1800.00 | 12960.00 | XXXX
12 | Rontek | 6RT1800SC-CX |  | 131 | 51 | 23 |  | orçamento | 7.20 | 3000.00 | 21600.00 | XXXX
13 | Rontek | 6LR61 |  | 48 | 26 | 16 |  | orçamento | 8.40 | 350.00 | 2940.00 | XXXX
14
15
16
17
18
19
20
21
22
23
24
25
