W8jonas/Internet-das-Vacas/relatorios/tabela testes consumo.xlsx

Sheet: tabela consumo
Especificações do teste: |  | valor | unidade
 | bateria | 750 | mAh
 | bateria | 2700000 | mAsec
Teste(nº) | Modo de funcionamento | Operação | Consumo (mA) | Tempo de operação (s) | Consumo (mAsec) | somatório consumo por ciclo | Consumo por hora(mAh) | Número de ciclos realizáveis | Duração total do circuito
 |  |  |  |  |  |  |  |  | Em horas | Em dias
1 | Valor X | Deep Sleep | 0.133 | 3540.000 | 470.820 | 4984.800 | 1.385 | 541.64661 | 541.64661 | 22.57
 | Valor Y | - | 0.000 | 0.000 | 0.000
 | Valor W | Transmit 802.11b POUT = + 20.5dBm | 75.233 | 60.000 | 4513.980
2 | Valor X | Deep Sleep | 0.133 | 3540.000 | 470.820 | 4756.800 | 1.321 | 567.60848 | 567.60848 | 23.65
 | Valor Y | - | 0.000 | 0.000 | 0.000
 | Valor W | Transmit 802.11n POUT = + 20.5dBm | 71.433 | 60.000 | 4285.980
3 | Valor X | Deep Sleep | 0.133 | 7190.000 | 956.270 | 1670.600 | 0.232 | 1616.18580 | 3232.37160 | 134.68
 | Valor Y | - | 0.000 | 0.000 | 0.000
 | Valor W | Transmit 802.11n POUT = + 20.5dBm | 71.433 | 10.000 | 714.330
4 | Valor X | Deep Sleep | 0.133 | 60.000 | 7.980 | 227.013 | 3.243 | 11893.59200 | 231.26429 | 9.64
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
