W8jonas/Internet-das-Vacas/relatorios/Analise de tensoes/Tabela Resultado analise de tensoes.xlsx

Sheet: Valores teóricos
Especificações do teste: |  | valor | unidade
bateria padrao do teste |  | 750 | mAh
 |  | 2700000 | mAsec
Uso de teste 1 | Valor X | Deep Sleep |  | 0.133 | 100.000 | 13.300 | 1908.465 | 15.268 | 1414.74955 | 49.12325 | 2.05
 | Valor Y | 100% uso do CPU |  | 76.900 | 20.000 | 1538.000
 | Valor W | Transmit 802.11n POUT = + 20.5dBm |  | 71.433 | 5.000 | 357.165
Uso de teste 2 | Valor X | Deep Sleep |  | 0.133 | 100.000 | 13.300 | 29679.900 | 59.360 | 90.97066 | 12.63481 | 0.53
 | Valor Y | 100% uso do CPU |  | 76.900 | 200.000 | 15380.000
 | Valor W | Transmit 802.11n POUT = + 20.5dBm |  | 71.433 | 200.000 | 14286.600
Horas percorridas (Teoria) | Valor de corrente na bateria (teste 1) | Valor de corrente na bateria (teste 1)
0 | 750 | 750
1 | 734.73228 | 690.6402
2 | 719.46456 | 631.2804
3 | 704.19684 | 571.9206
4 | 688.92912 | 512.5608
5 | 673.6614 | 453.201
6 | 658.39368 | 393.8412
7 | 643.12596 | 334.4814
8 | 627.85824 | 275.1216
9 | 612.59052 | 215.7618
10 | 597.3228 | 156.402
11 | 582.05508 | 97.0422
12 | 566.78736 | 37.6824
13 | 551.51964 | -10
14 | 536.25192 | -10
15 | 520.9842 | -10
16 | 505.71648 | -10
17 | 490.44876 | -10
18 | 475.18104 | -10
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
