W8jonas/Internet-das-Vacas/relatorios/Analise de tensoes/Tabela de tensões - teste prático 1-V2.xlsx

Data | Contagem de tempo | Sensor 1 - ESP32 bateria de 750 mAh | Sensor 2 - ESP 8266 bateria de 750 mAh | Sensor 3 - ESP 8266 bateria de 700 mAh
2018-09-03 | 18.00 | 3.43 | 3.44 | 2.79
2018-09-03 | 19.00 | 3.43 | 3.44 | 2.82
2018-09-03 | 20.00 | 3.43 | 3.43 | 2.79
2018-09-03 | 21.00 | 3.42 | 3.43 | 2.76
2018-09-03 | 22.00 | 3.42 | 3.43 | 2.82
2018-09-03 | 23.00 | 3.42 | 3.43 | 2.84
2018-09-03 | 24.00 | 3.42 | 3.43 | 2.82
2018-09-03 | 25.00 | 3.42 | 3.43 | 2.78
2018-09-03 | 26.00 | 3.42 | 3.43 | 2.83
2018-09-03 | 27.00 | 3.42 | 3.43 | 2.82
2018-09-03 | 28.00 | 3.42 | 3.43 | 2.84
2018-09-03 | 29.00 | 3.42 | 3.43 | 2.84
2018-09-03 | 30.00 | 3.42 | 3.43 | 2.84
2018-09-03 | 31.00 | 3.42 | 3.43 | 2.85
2018-09-03 | 32.00 | 3.42 | 3.43 | 2.87
2018-09-03 | 33.00 | 3.42 | 3.43 | 2.86
2018-09-03 | 34.00 | 3.42 | 3.43 | 2.87
2018-09-03 | 35.00 | 3.42 | 3.43 | 2.84
2018-09-03 | 36.00 | 3.42 | 3.43 | 2.87
2018-09-03 | 37.00 | 3.42 | 3.43 | 2.87
2018-09-03 | 38.00 | 3.42 | 3.43 | 2.88
2018-09-03 | 39.00 | 3.42 | 3.43 | 2.87
2018-09-03 | 40.00 | 3.42 | 3.43 | 2.8
2018-09-03 | 41.00 | 3.42 | 3.43 | 2.75
2018-09-03 | 42.00 | 3.42 | 3.43 | 2.8
2018-09-03 | 43.00 | 3.42 | 3.43 | 2.79
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
