W8jonas/Internet-das-Vacas/hardware/schematic v1.1.0.pdf

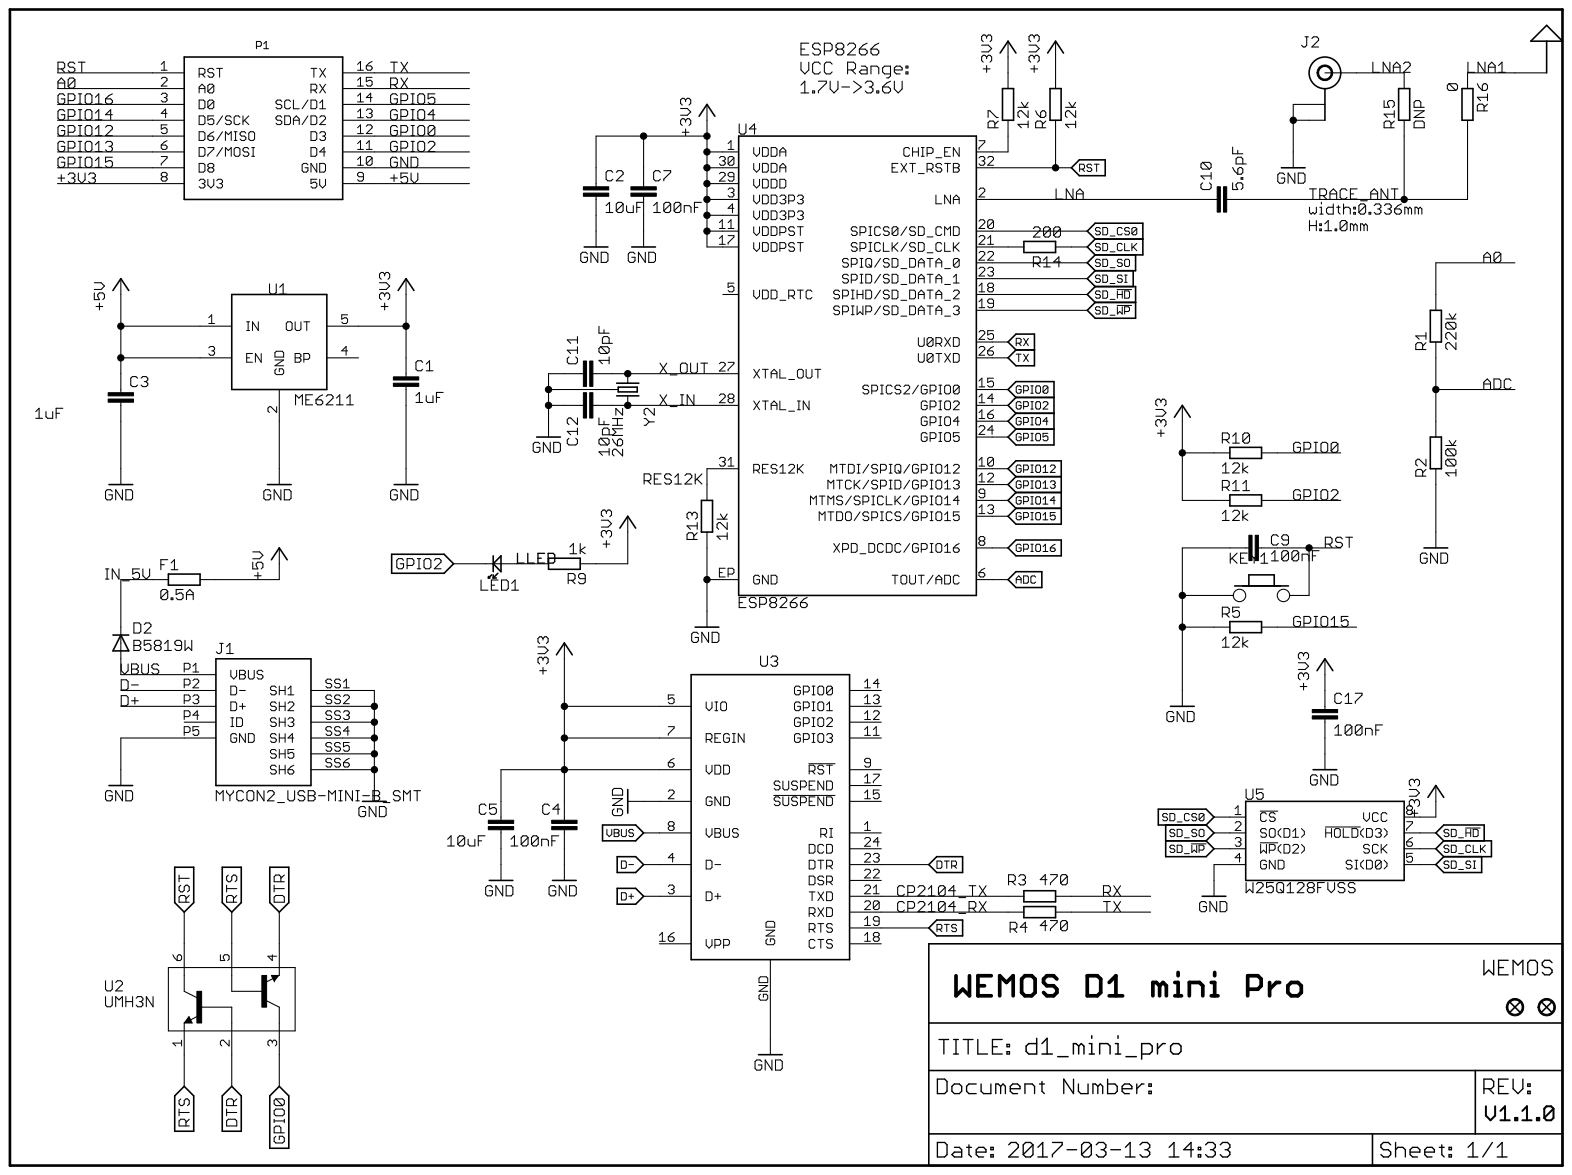
[picture p118: page 1]
