W8jonas/Internet-das-Vacas/relatorios/Termo_Fernando Teixeira.pdf

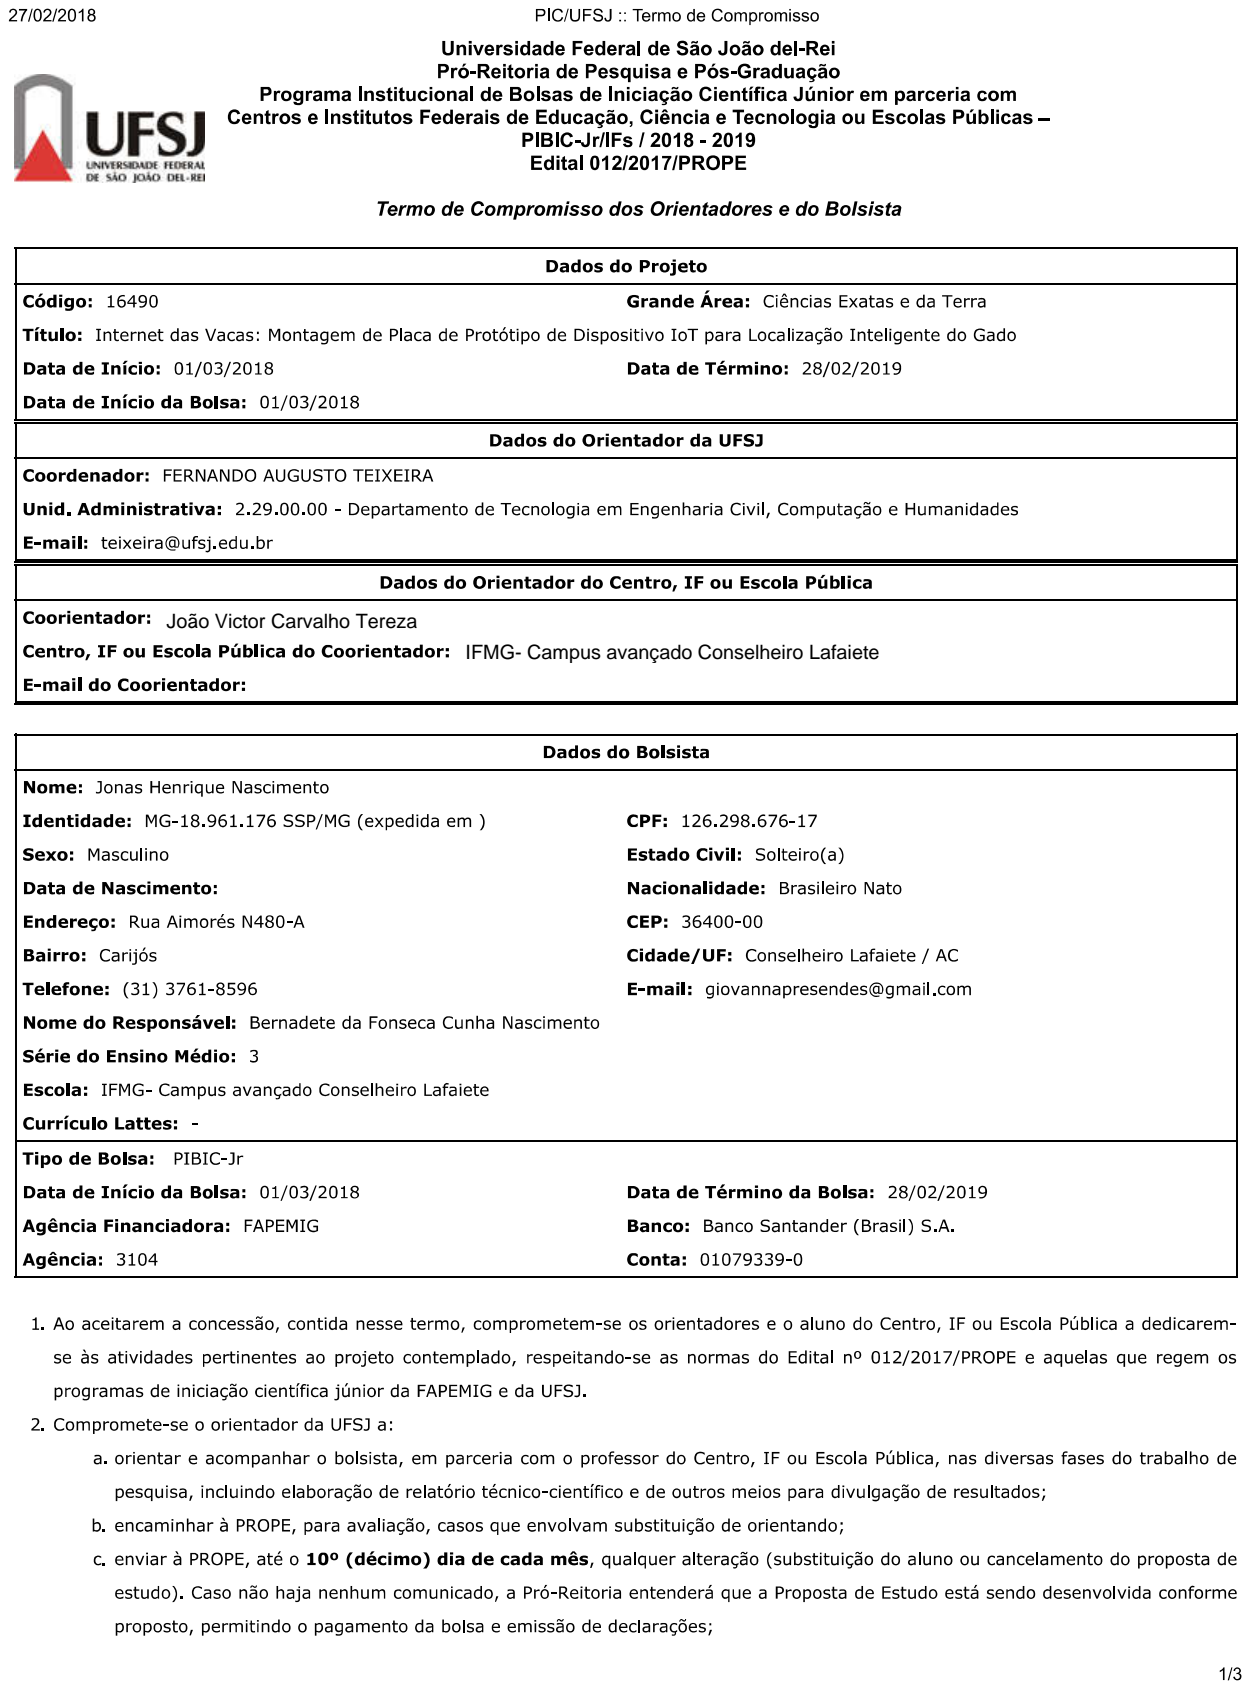
[picture p119: page 1]

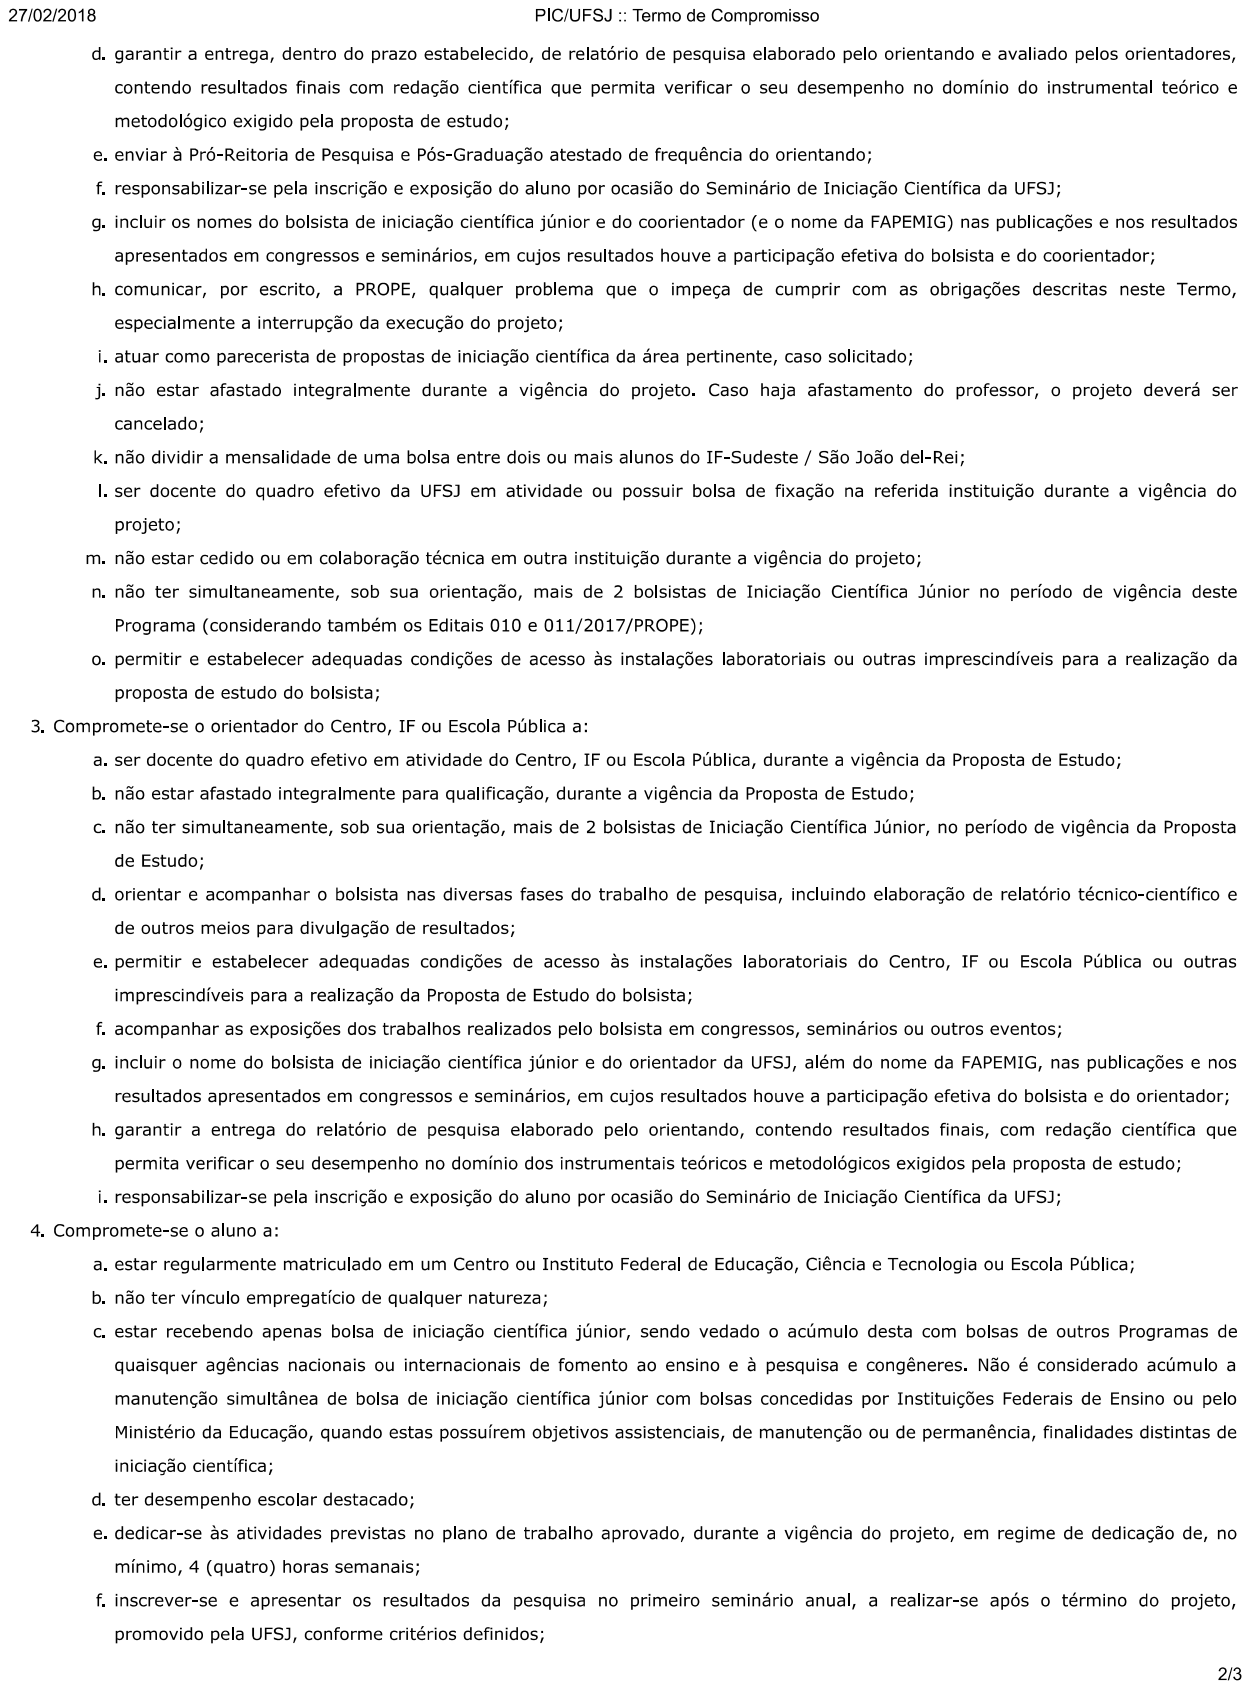
[picture p120: page 2]

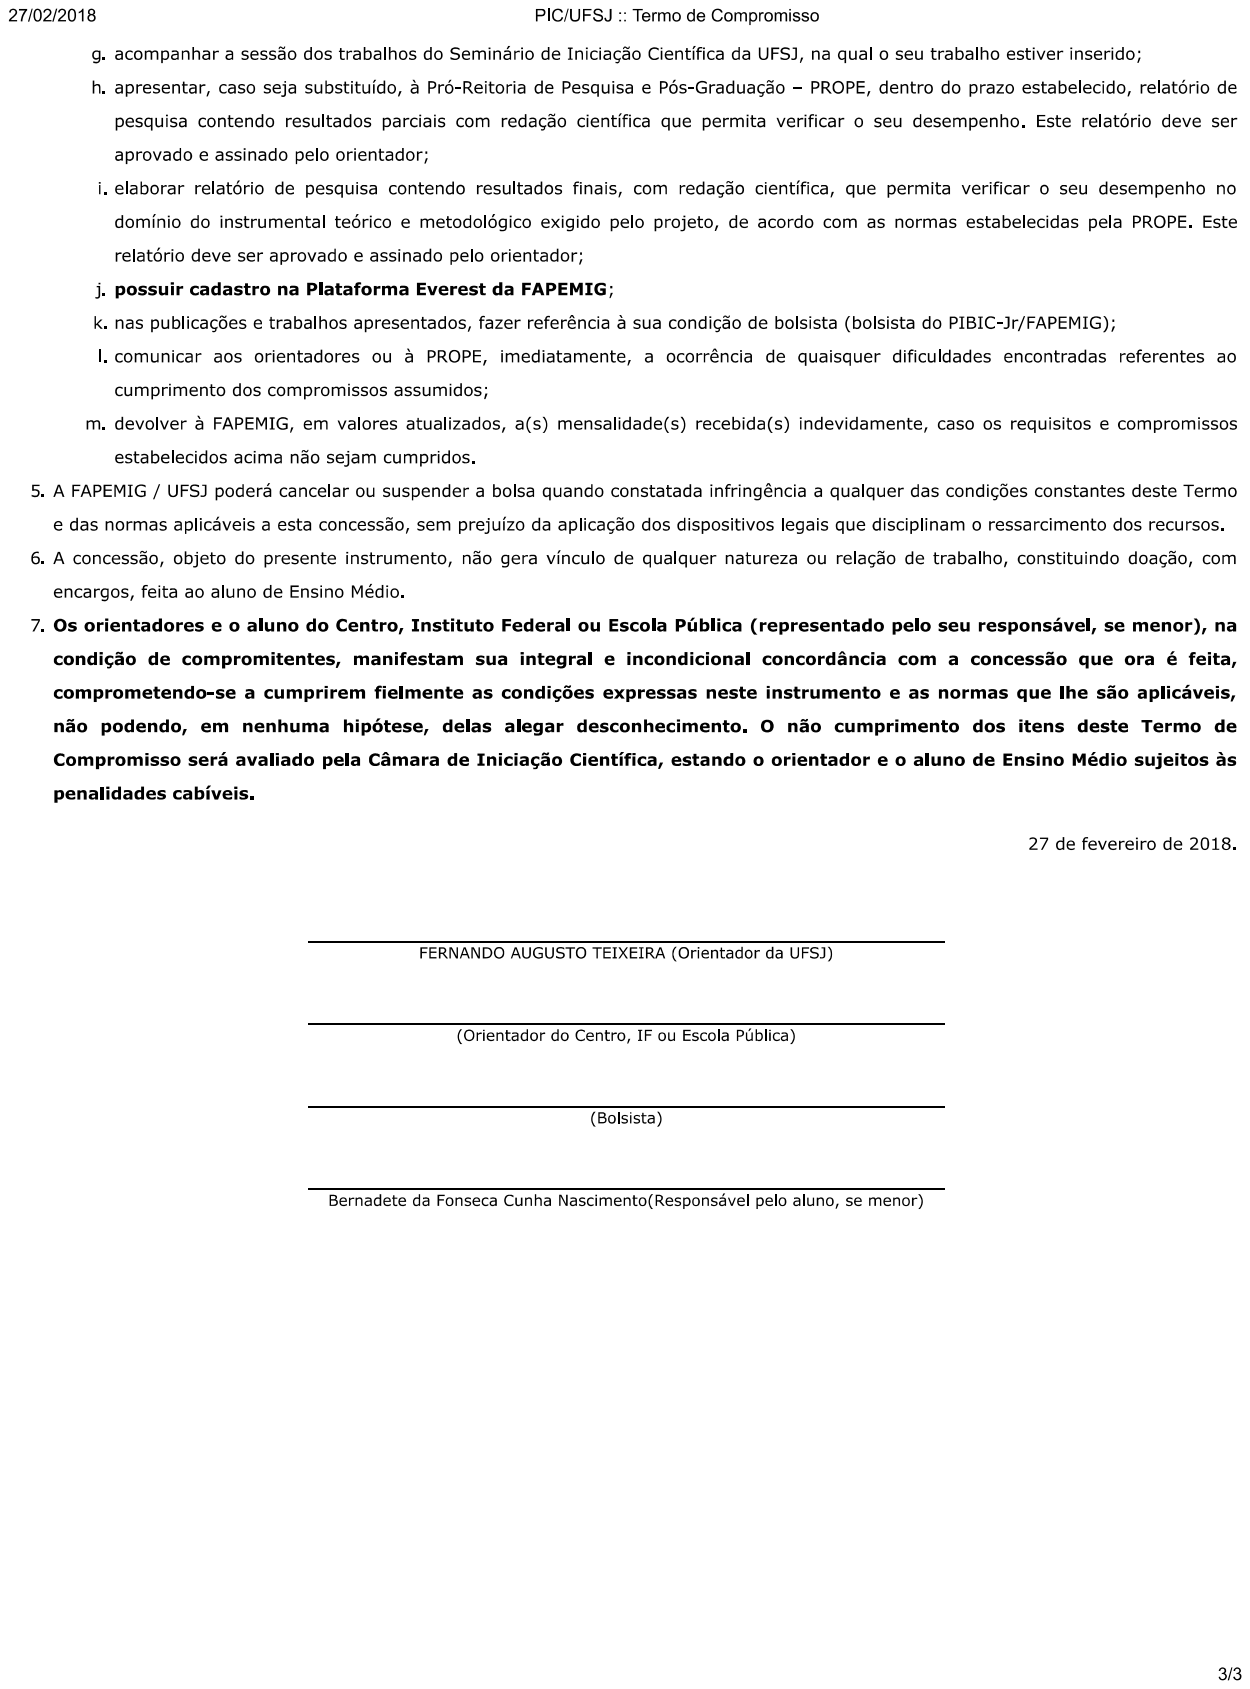
[picture p121: page 3]
