W8jonas/Internet-das-Vacas/(list of files, drawings)

Other design files:
hardware/Esquemático shield.pdsprj
