W8jonas/Internet-das-Vacas/programacao/Monitoramento_de_tensao/Monitoramento_de_tensao.ino

/*
 * Instituto Federal de Educação, Ciência e Tecnologia Minas Gerais
 * IFMG - Campus Avançado Conselheiro Lafaiete 
 * 
 * Internet das Vacas código monitoramento de tensão
 * Autor: Jonas Henrique Nascimento
 * PIBIC-Junior
 * 
 * Data de início: 26/08/2018
 * Data da ultima atualização: 03/09/2018
 * Data de término: 02/09/2018
 * 
 * 
 *
 *  Este código está disponível sempre no endereço abaixo, para livre aperfeiçoamento. 
 *  Todavia, pede-se por educação, que ao compartilharem o código, mantenham os autores
 *  originais, tão bem quanto o nome da instituição.
 *  
 *  https://github.com/W8jonas/Internet-das-Vacas/blob/master/programacao/Monitoramento_de_tensao/Monitoramento_de_tensao.ino
 *  
 */


#include <DS3231.h>
#include <SPI.h>
#include <SD.h>
#define chip_select 4
#define Sinal_1 5
#define Sinal_2 6

int sensorPin   = A0;
float sensorValue = 0;

int sensorPin2   = A1;
float sensorValue2 = 0;

unsigned int minuto_antigo = 0;
unsigned int minuto_atual = 0;

void leitura();

DS3231  rtc(SDA, SCL);
Time  t;
File datalogger;

void setup() {

   pinMode(Sinal_1, INPUT);
   pinMode(Sinal_2, INPUT);
   
   Serial.begin(115200);
   rtc.begin();
   while (!Serial) {;}
   
   if (!SD.begin(chip_select)) {
     Serial.println("Erro ao ler cartao de memoria");
     return;
  }
  
}


void loop() {
   t = rtc.getTime();
   minuto_atual = t.min;
   
   if ( minuto_antigo != minuto_atual ){  
      minuto_antigo = minuto_atual;
      
      leitura();
      datalogger = SD.open("Tensoes_2.svc", FILE_WRITE);
      if ( datalogger ) {
         Serial.println("Atualizando datalogger");
         Serial.print(rtc.getDateStr());
         Serial.print("  ");
         Serial.println(rtc.getTimeStr());
         Serial.print("Sensor 1 - ESP32 bateria de 750 mAh......: ");
         Serial.println(sensorValue);
         Serial.print("Sensor 2 - ESP 8266 bateria de 750 mAh...: ");
         Serial.println(sensorValue2);
         Serial.println(" ");
//         datalogger.println("Data,Hora,sensorValue,sensorValue2,sensorValue3");
         datalogger.print(rtc.getDateStr());
         datalogger.print(",");
         datalogger.print(rtc.getTimeStr());
         datalogger.print(",");
         datalogger.print(sensorValue);
         datalogger.print(",");
         datalogger.print(sensorValue2);
         datalogger.print(",");
         datalogger.println(",  ");
         datalogger.close();
      } else {
         Serial.println("Erro ao abrir datalogger");
      }
      Serial.println("Atualizado");
   }

   if(digitalRead(Sinal_1) == HIGH){
      if(minuto_atual+3 > marcador_minuto){
         Serial.println("Erro no ESP 8266");
         cont_erros_esp8266++;
         Serial.println("O total de erros foi: ");
         Serial.println(cont_erros_esp8266);
         marcador_minuto = minuto_atual;
         
      }
   }

   if(digitalRead(Sinal_2) == HIGH){
     if(minuto_atual+3 > marcador_minuto){
       Serial.println("Erro no ESP32");
       cont_erros_esp32 ++;
       Serial.print("O total de erros foi: ");
       Serial.println(cont_erros_esp32);
       marcador_minuto = minuto_atual;
       
     }
   }
   
}


void leitura() {
   int x = 0;
   float sensorValue_soma = 0;
   float sensorValue_soma2 = 0;
  
   while ( x < 10 ) {
      sensorValue = analogRead(sensorPin);
      sensorValue = (sensorValue * 3.75 ) / 843;
      sensorValue_soma = sensorValue + sensorValue_soma;
      
      sensorValue2 = analogRead(sensorPin2);
      sensorValue2 = (sensorValue2 * 3.75 ) / 843;
      sensorValue_soma2 = sensorValue2 + sensorValue_soma2;
      
      x++;
      Serial.print(sensorValue);
      Serial.print(" | ");
      Serial.print(sensorValue2);
   }
   
   sensorValue = sensorValue_soma / 10;
   sensorValue2 = sensorValue_soma2 / 10;
   
   Serial.print(sensorValue);
   Serial.print(" | ");
   Serial.print(sensorValue2);
   
}
