W8jonas/Internet-das-Vacas/(commit log)

2018-05-24 projeto IDV final de maio
    [Internet das vacas PIBIC-Jonas.xlsx, tabela 2.xlsx]
2018-05-25 Correção de erros ortográficos e novo tópico, resultado final
2018-05-25 Mudança de nomes e pequena alteração no sumário
2018-06-04 Correção de pequenos problemas e aprimoramento do relatório; Retirada do que nao foi realizado por causa dos imprevistos
2018-06-04 Versao aprimorada e organizada
    [Internet das vacas PIBIC-Jonas.xlsx, tabela 2.xlsx]
2018-06-04 Remoção de arquivos desnecessarios
2018-06-05 Adicao do esquematico, base pra novo modelo de tabela e imagens separadas da placa
    [Esquemático shield.pdsprj]
2018-06-06 ADD + modelos de baterias, link do git no cronograma, referencia a placa shiel e o codigo teste 1
    [filtro para tabela modelos de bateria minamoto.xlsx]
2018-06-06 Remocao de arquivo sem utilidade agora
2018-06-06 Alteracao no nome do arquivo principal, de cronograma para relatorio, esta mudanca se justifica por necessidade de melhor organizacao
2018-06-06 Acrescao de emails na mensagem salva; Organizacao melhorada acrescimo de algumas informacoes
2018-06-07 Novo datasheet incrementado, novas tabelas construidas - Acrecao das notas de rodape e das referencias
2018-06-08 Codigo 1 com botao, esquematico att; relatorio com tabela att
    [Esquemático shield.pdsprj]
2018-06-09 Tabela parcialmente completa. Shield refeita do zero para melhor desempenho
2018-06-10 Adicionado novos datasheet; Adicao de cabecalho nos codigos; Tabela parcialmente concluida com o novo codigo de economia de energia
2018-06-13 Tabela modelos de energia completa; Video explicativo economia de energia
2018-06-19 Tabela valores medidos completo; Inicio de medias
2018-06-22 Finalizacao tabela 3; Atualizacao em cronograma das metas; Inicio de nova tabela sobre autonomia dos modelos de bateria
    [tabela 3.xlsx]
2018-06-23 Nova tabela de consumo x autonomia feita em excel; metas em cfg
    [metas 06 - Junho.cfg, tabela testes consumo.xlsx]
2018-06-26 Primeiro grafico e tabela autonomia
    [gráficos 1.xlsx, metas 06 - Junho.cfg, tabela testes consumo.xlsx]
2018-07-03 Check update
    [tabela testes consumo.xlsx]
2018-07-07 Grafico reformulado - relatorio, adicao das equacoes no relatorio e texto conclusivo
    [metas 06 - Junho.cfg, tabela testes consumo.xlsx]
2018-07-08 Correcao de erros no grafico, texto conclusivo preliminar e explanacao das contas
    [tabela testes consumo.xlsx]
2018-07-11 Mudanca no grafico, tabela de autonomia atualizada, modelos de bateria add
    [tabela testes consumo.xlsx]
2018-07-22 Alteracao de imagens, separacao -- modelos 1&2; Resumo planeta inovacao +det
    [tabela testes consumo.xlsx]
2018-07-22 Atualizacao de codigos -- cabecalho; Att shield esquematico
    [Esquemático shield.pdsprj, metas 06 - Junho.cfg]
2018-08-03 Add imagens, att de relatorio planeta brasil
2018-08-06 Planeta inovacao resumo v2; att de regras;
2018-08-06 Finalizado resumo, chegar erros basicos; add de imagem;
2018-08-09 Finalizado para envio planeta inovacao
2018-08-16 Arquivos banner
    [tabela testes consumo.xlsx]
2018-09-08 Planilhas monitoramento tensao; Banner att; Relatorio planeta inovacao att; att em codigos - modificacoes genericas
    [Tabela de tensões - teste prático 1-V2.xlsx, tabela testes consumo.xlsx]
2018-09-11 Monitoramento de tensao 2 - 2 teste; pos analise; arquivos movidos - pasta pos analise; primeiras tabelas de analise de tensao;
    [Tabela de tensões - teste prático 1-V2.xlsx, tabela tensoes 2.xlsx]
2018-09-11 Link em todos os codigos; Versao 2.1 de monitoramento de tensao
2018-09-17 Tensoes 4; monitoramento 2.1; tabela de analise de tensoes v1;
    [Tabela Resultado analise de tensoes.xlsx]
2018-09-17 Graficos com indicacoes;
    [Tabela Resultado analise de tensoes.xlsx]
2018-09-23 Monitoramento de tensao 2.2 e 2.3; Cronograma att; arquivos do SD
    [Tabela Resultado analise de tensoes.xlsx]
2018-10-22 Analise cartaoSD; + 1 tabela; inicio do banner
    [Tabela Resultado analise de tensoes.xlsx]
2018-10-22 banner finalizado
    [Tabela Resultado analise de tensoes.xlsx]
2018-11-19 Att geral
    [Tabela Resultado analise de tensoes.xlsx]
2018-12-17 Relatorio final - etapas desenvolvimento - migracao para git lab
    [Tabela Resultado analise de tensoes.xlsx]
